DangerousPrototypes/BusPirateUltraHardware/BPUv1_case/freecad/images/bpu assembled - transparent front.png

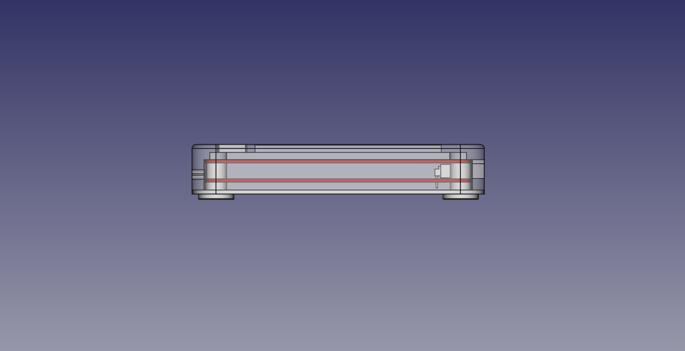
BPUv1_case/freecad/images/bpu assembled - transparent front.png
