DangerousPrototypes/BusPirateUltraHardware/BPUv1_case/freecad/images/bpu assembled - solid.png

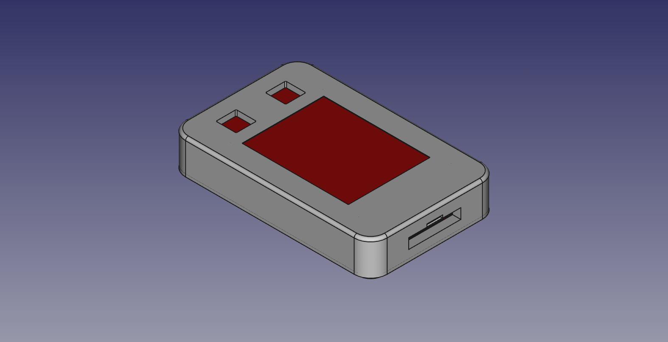
BPUv1_case/freecad/images/bpu assembled - solid.png
