DangerousPrototypes/BusPirateUltraHardware/README.md

# BusPirateUltraHardware
Schematic and PCBs for Bus Pirate Ultra
