DangerousPrototypes/BusPirateUltraHardware/BPU_display/font.bmp

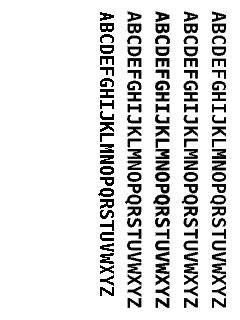
BPU_display/font.bmp
