DangerousPrototypes/BusPirateUltraHardware/BPUv1_case/freecad/images/bpu bottom.png

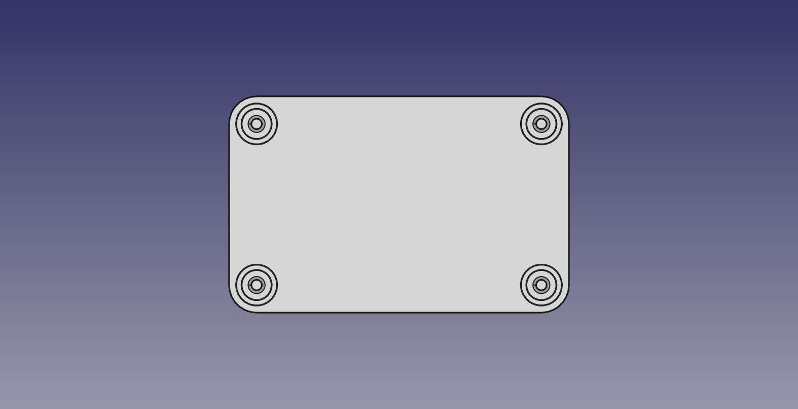
BPUv1_case/freecad/images/bpu bottom.png
