DangerousPrototypes/BusPirateUltraHardware/BPUv1_case/freecad/images/bpu top.png

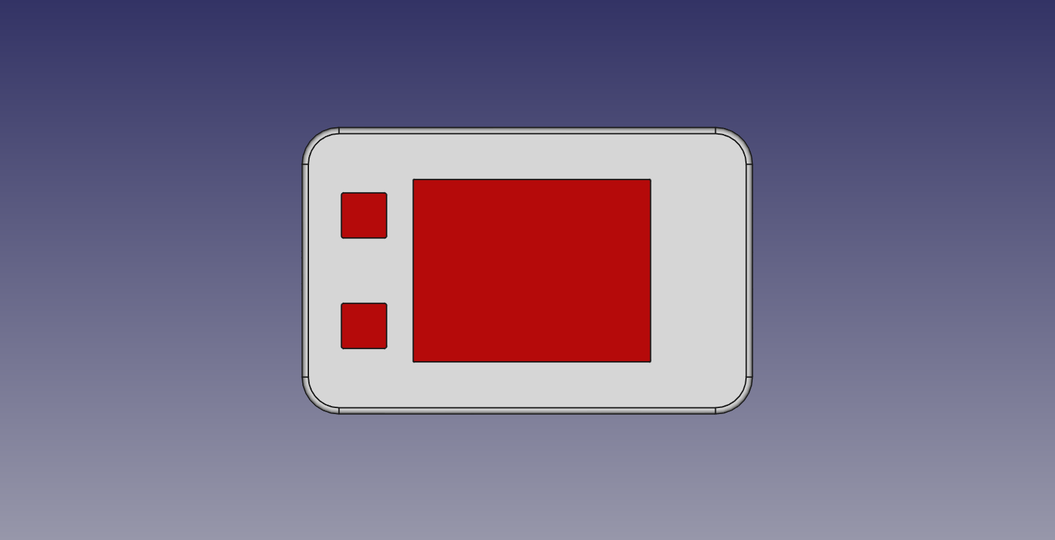
BPUv1_case/freecad/images/bpu top.png
