DangerousPrototypes/BusPirateUltraHardware/BPUv1_case/freecad/assemblies/All Bus Pirate Ultra v1.0 assembly.FCStd

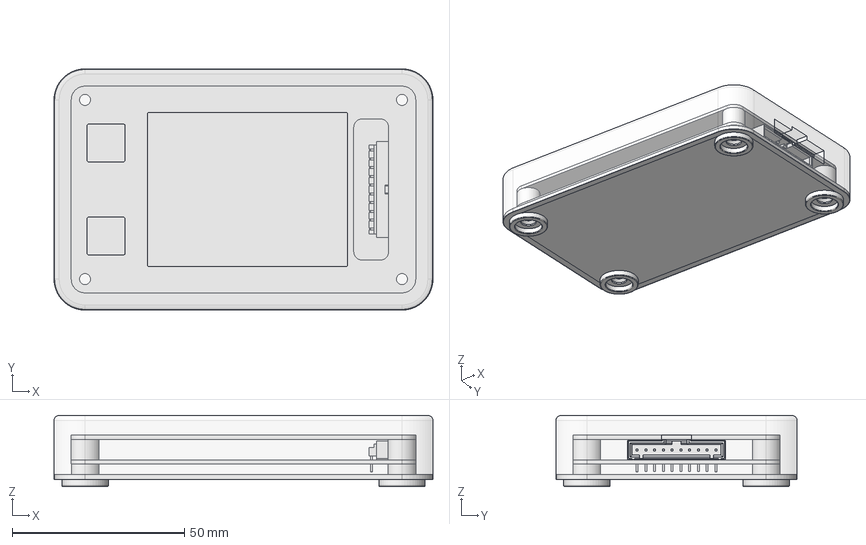
[picture p6: CAD file, 2020-06-01]
BPUv1_case/freecad/assemblies/All Bus Pirate Ultra v1.0 assembly.FCStd
110.0 x 70.0 x 20.7 mm
Bus Pirate Ultra v1.0 bottom plate_Body_001
spacer-3mm_001
spacer-3mm_002
spacer-3mm_003
spacer-3mm_004
spacer-6mm_001
spacer-6mm_002
spacer-6mm_003
spacer-6mm_004
Bus Pirate Ultra v1.0 display_001
PCB Bus Pirate Ultra v1.0 - assembly_001
Bus Pirate Ultra v1.0 case_Body001_001
