DangerousPrototypes/BusPirateUltraHardware/BPUv1_case/freecad/assemblies/PCB Bus Pirate Ultra v1.0 - assembly.FCStd

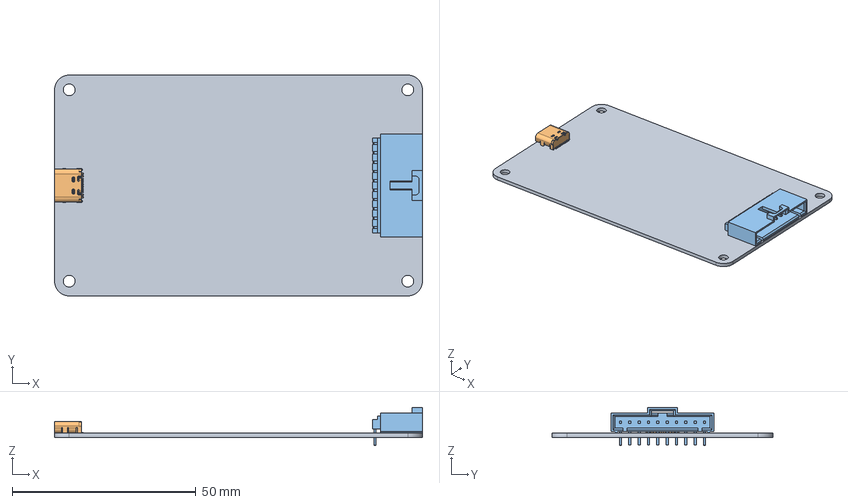
[picture p7: CAD file, 2020-06-01]
BPUv1_case/freecad/assemblies/PCB Bus Pirate Ultra v1.0 - assembly.FCStd
100.0 x 60.0 x 10.4 mm
PCB Bus Pirate Ultra v1.0_001
Part type-c-31-m-12-1_001
Part molex 7055 30044_001
