DangerousPrototypes/BusPirateUltraHardware/BPUv1_case/freecad/external sources/Part type-c-31-m-12-1.FCStd

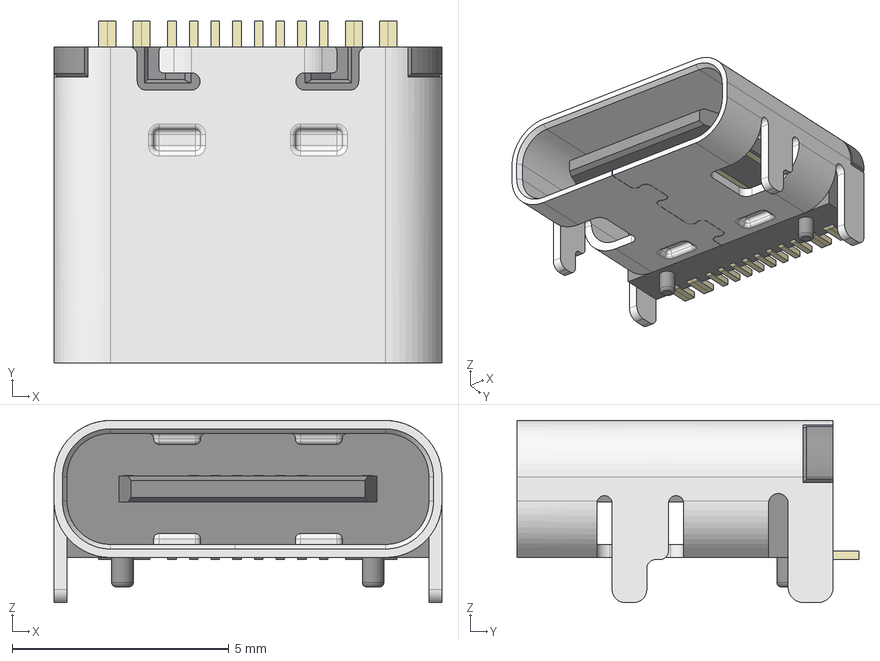
[picture p8: CAD file, 2020-06-01]
BPUv1_case/freecad/external sources/Part type-c-31-m-12-1.FCStd
8.95 x 7.90 x 4.20 mm
ConPins
PcbPins
Mold
Frame
