DangerousPrototypes/BusPirateUltraHardware/BPUv1_case/freecad/parts/Bus Pirate Ultra v1.2 case.FCStd

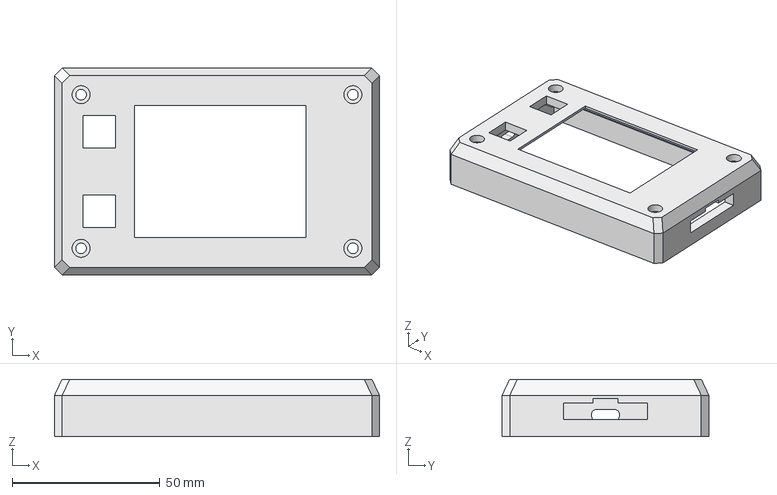
[picture p9: CAD file, 2021-04-14]
BPUv1_case/freecad/parts/Bus Pirate Ultra v1.2 case.FCStd
110.0 x 70.0 x 19.4 mm
