DangerousPrototypes/BusPirateUltraHardware/BPUv1_case/freecad/external sources/Part molex 7055 30044.FCStd

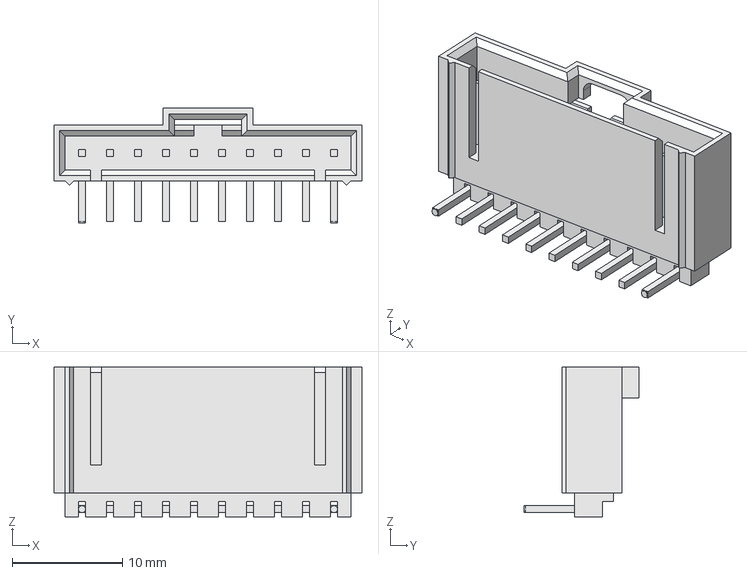
[picture p10: CAD file, 2020-06-01]
BPUv1_case/freecad/external sources/Part molex 7055 30044.FCStd
27.9 x 10.4 x 13.6 mm
