DangerousPrototypes/BusPirateUltraHardware/BPUv1_case/freecad/parts/Bus Pirate Ultra v1.1 bottom plate.FCStd

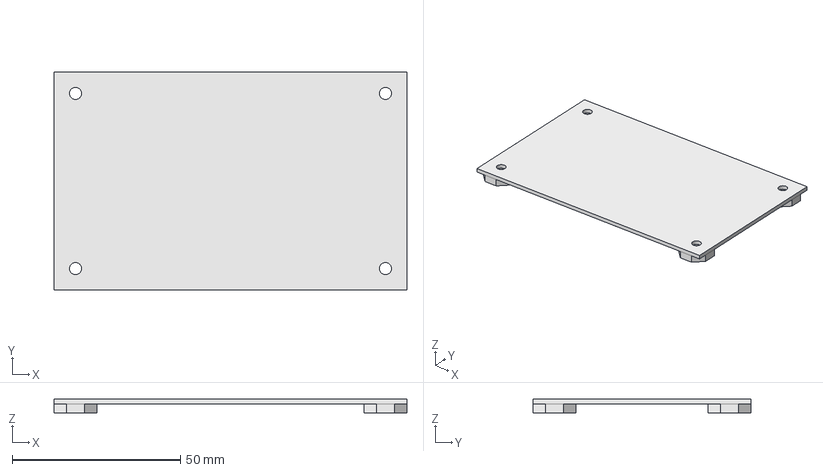
[picture p11: CAD file, 2021-04-13]
BPUv1_case/freecad/parts/Bus Pirate Ultra v1.1 bottom plate.FCStd
104.8 x 64.8 x 4.25 mm
