DangerousPrototypes/BusPirateUltraHardware/BPUv1_case/freecad/parts/spacer-6mm.FCStd

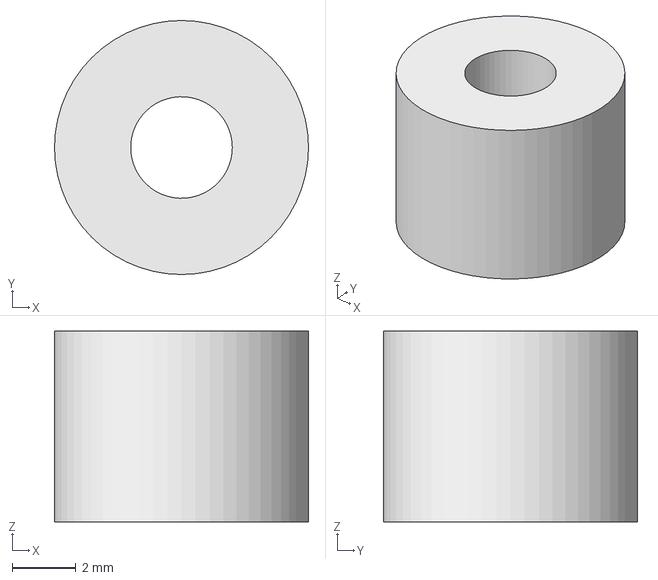
[picture p12: CAD file, 2020-06-01]
BPUv1_case/freecad/parts/spacer-6mm.FCStd
8.00 x 8.00 x 6.00 mm
