DangerousPrototypes/BusPirateUltraHardware/BPUv1_case/freecad/parts/spacer-3mm.FCStd

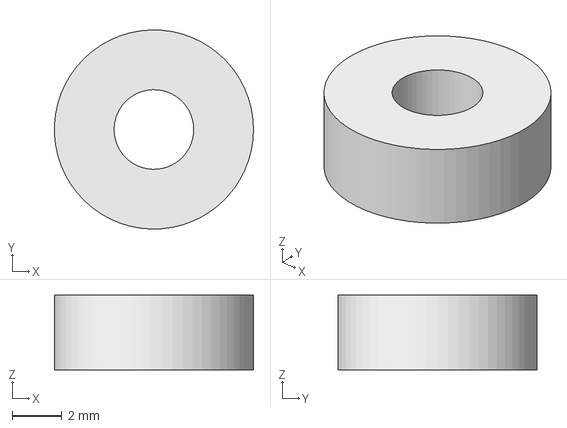
[picture p13: CAD file, 2020-06-01]
BPUv1_case/freecad/parts/spacer-3mm.FCStd
7.99 x 8.00 x 3.00 mm
