DangerousPrototypes/BusPirateUltraHardware/BPUv1_case/freecad/parts/PCB Bus Pirate Ultra v1.0.FCStd

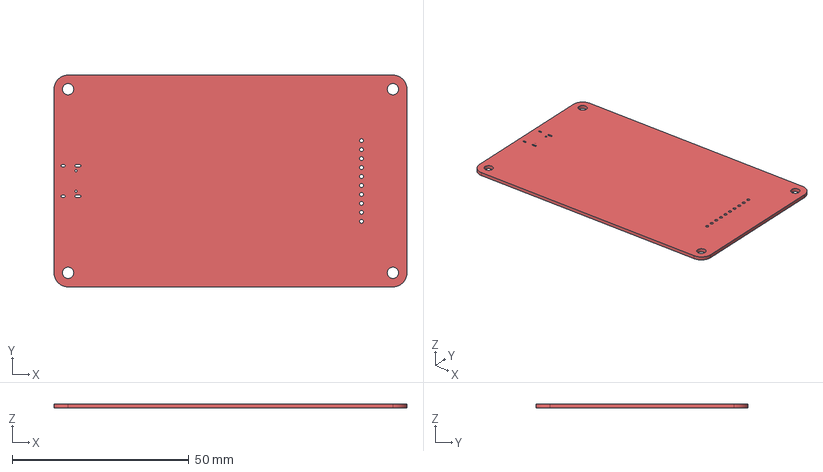
[picture p14: CAD file, 2020-06-01]
BPUv1_case/freecad/parts/PCB Bus Pirate Ultra v1.0.FCStd
100.0 x 60.0 x 1.20 mm
