DangerousPrototypes/BusPirateUltraHardware/BPUv1_case/freecad/parts/Bus Pirate Ultra v1.0 bottom plate.FCStd

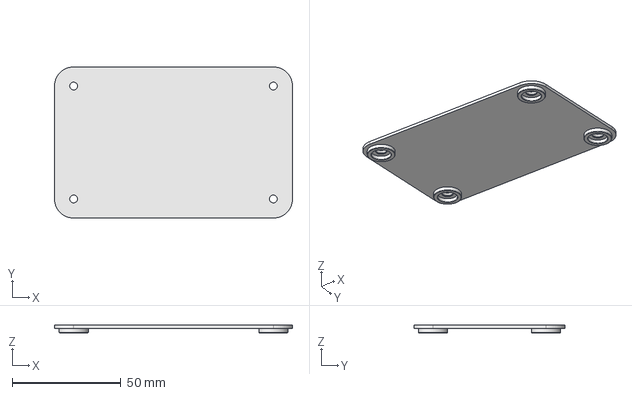
[picture p15: CAD file, 2020-06-01, an earlier design]
BPUv1_case/freecad/parts/Bus Pirate Ultra v1.0 bottom plate.FCStd
109.6 x 69.6 x 3.50 mm
