DangerousPrototypes/BusPirateUltraHardware/(list of files, cad)

Other CAD files:
BPU_display/board_outline.dwg
BPUv1_case/freecad/parts/PCB Bus Pirate Ultra v1.0 display.FCStd
BPUv1_case/freecad/parts/Bus Pirate Ultra v1.1 case.FCStd
BPUv1_case/freecad/parts/Bus Pirate Ultra v1.0 case.FCStd
