DangerousPrototypes/BusPirateUltraHardware/BPUv1_case/freecad/images/bpu assembled - ortho io side.png

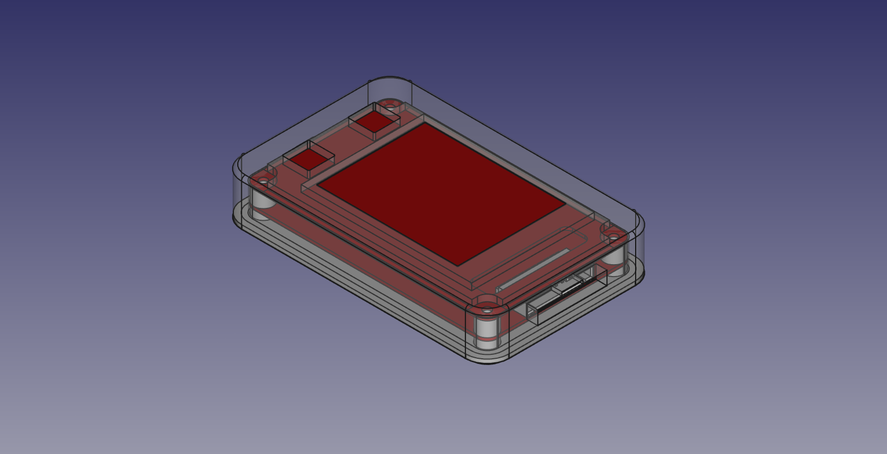
BPUv1_case/freecad/images/bpu assembled - ortho io side.png
