DangerousPrototypes/BusPirateUltraHardware/BPUv1_case/freecad/images/bpu assembled - transparent bottom ortho.png

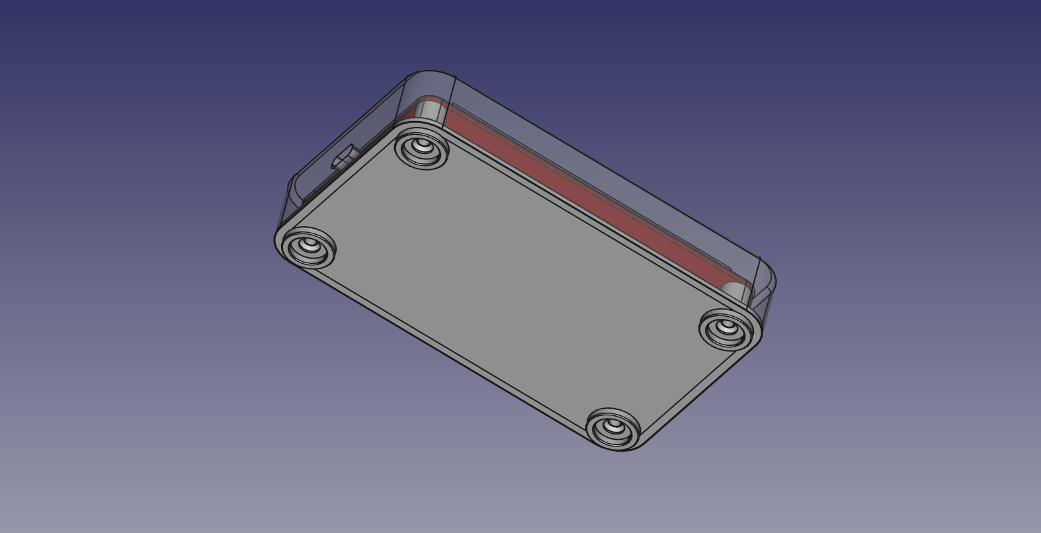
BPUv1_case/freecad/images/bpu assembled - transparent bottom ortho.png
