DangerousPrototypes/BusPirateUltraHardware/BPUv2a/BPUv2a.kicad_pcb

## KiCad design BPUv2a/BPUv2a.kicad_pcb (2020-04-21)

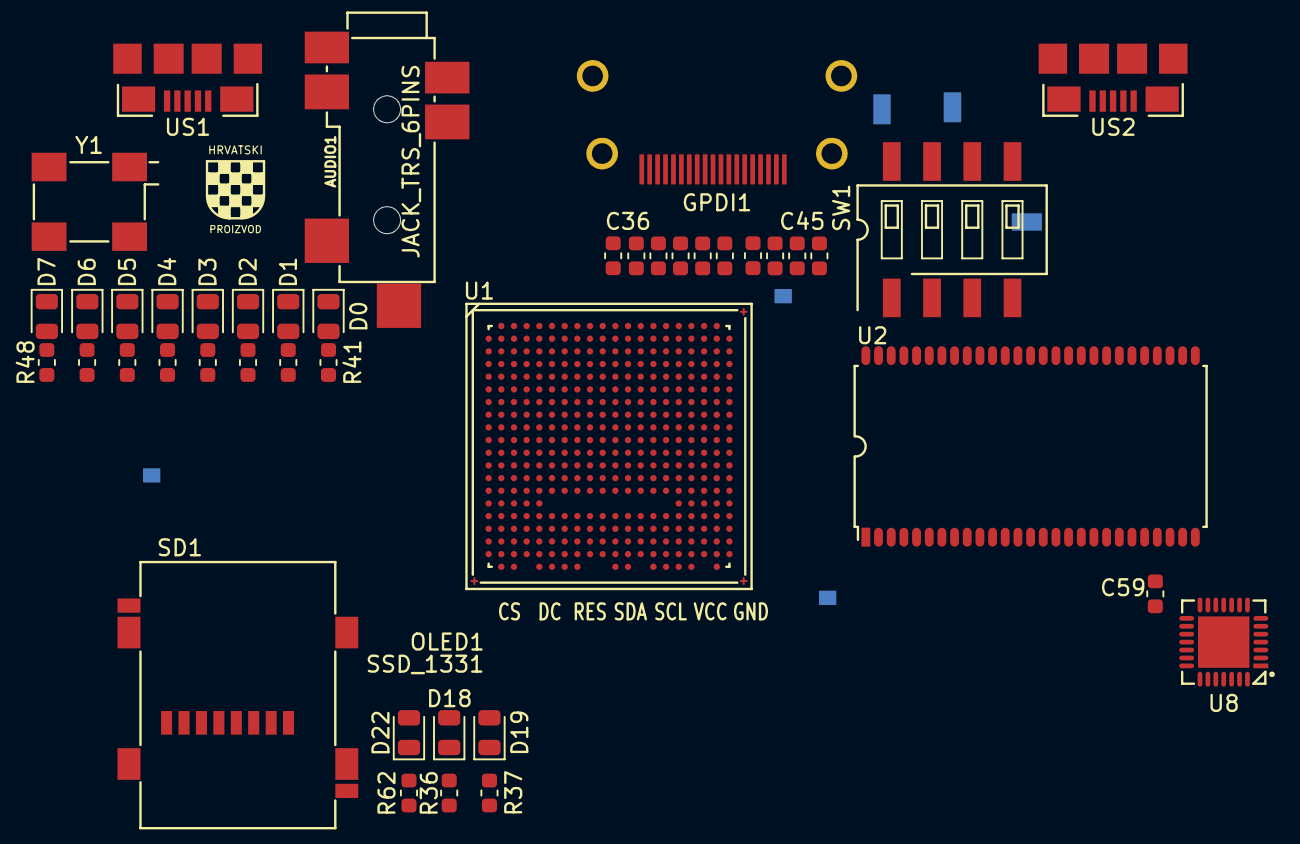
[picture p18: board BPUv2a.kicad_pcb from above]

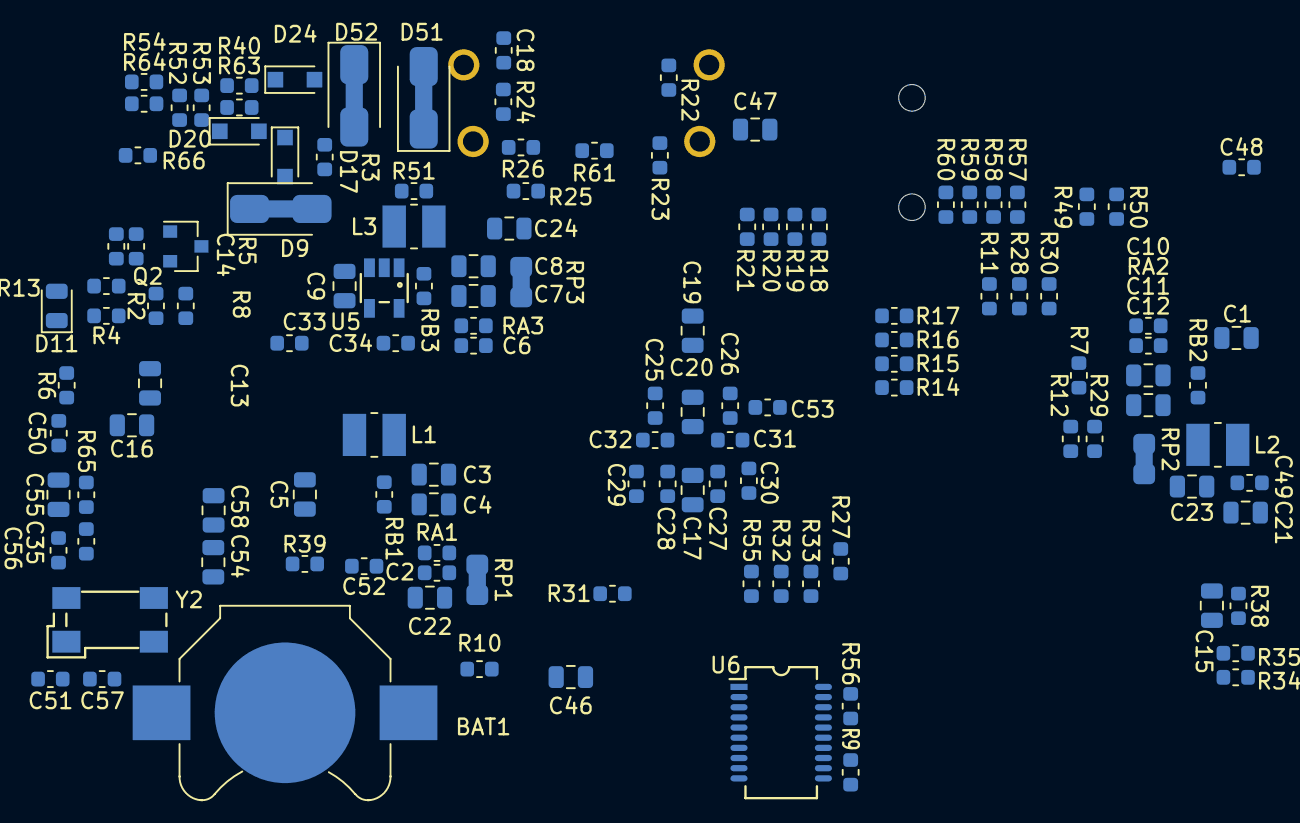
[picture p19: board BPUv2a.kicad_pcb from below]

Board: 4 copper layers, 171 parts (126 on the bottom side), 188 nets, no tracks yet.

Parts:
AUDIO1: JACK_TRS_6PINS; CUI_SJ-43516-SMT
BAT1: CR1225; Keystone_3000_1x12mm-CoinCell
C1, C3, C4, C5, C7, C8, C9, C11, C12, C15, C21, C54, C55, C58: 22uF; C_0805_2012Metric
C2, C6, C10, C18: 470pF; C_0603_1608Metric
C13, C16, C17, C19, C20, C22, C23, C24, C46, C47: 2.2uF; C_0805_2012Metric
C14, C36, C37, C38, C39, C40, C41, C42, C43, C44, C45, C59: 220nF; C_0603_1608Metric
C25, C26, C27, C28, C29, C30, C31, C32, C33, C34, C35, C48, C49, C50, C51, C52, C53: 22nF; C_0603_1608Metric
C56, C57: 3.3pF; C_0603_1608Metric
D0, D4, D11, D19: RED; LED_0805_2012Metric
D1, D5: ORANGE; LED_0805_2012Metric
D2, D6, D18: GREEN; LED_0805_2012Metric
D3, D7, D22: BLUE; LED_0805_2012Metric
D9, D51, D52: 0; D_SMA_Jumper_NC
D17, D24: 1N914; D_SOD-323_HandSoldering
D20: 3.6V; D_SOD-323_HandSoldering
GPDI1: GPDI-D; CONN-10029449-111RLF
HR: HR; hrvatski
L1, L2, L3: 2.2uH; L_1008_1210
OLED1: SSD_1331; oled_13xx
Q2: 2N7002; SOT-23
R2: 18k; R_0603_1608Metric
R3, R4, R25, R26, R30: 4.7k; R_0603_1608Metric
R5: 2.2M; R_0603_1608Metric
R6, R8, R14, R18, R29, R40, R54, R57, R66: 1.1k; R_0603_1608Metric
R7, R10, R17, R21, R39, R51, R60: 130; R_0603_1608Metric
R9, R13, R31, R32, R33, R34, R55, R63, R64: 15k; R_0603_1608Metric
R11, R12, R27, R28: 10k; R_0603_1608Metric
R15, R19, R35, R36, R37, R41, R42, R43, R44, R45, R46, R47, R48, R58, R61, R62, R65: 549; R_0603_1608Metric
R16, R20, R59: 270; R_0603_1608Metric
R22, R23: 3.3k; R_0603_1608Metric
R24: 100k; R_0603_1608Metric
R38: 0.47; R_0603_1608Metric
R49, R50, R52, R53: 27; R_0603_1608Metric
R56: 0; R_0603_1608Metric
RA1, RA2, RA3: 15k; R_0603_1608Metric
RB1: 18k; R_0603_1608Metric
RB2: 4.7k; R_0603_1608Metric
RB3: 3.3k; R_0603_1608Metric
RP1, RP2, RP3: 0; R_0805_2012Metric_Pad1.29x1.40mm_HandSolder_Jumper_NC
SD1: SCHD3A0100; SCHD3A100
SW1: SW_DIP_x04; SW_DIP_x4_W8.61mm_Slide_LowProfile
U1: LFE5U-85F-6BG381C; BGA-381_pitch0.8mm_dia0.4mm
U2: MT48LC16M16A2TG; TSOP54
U5: TLV62569DBV; TSOT-25
U6: FT231XS; FT231X-SSOP-20_4.4x6.5mm_Pitch0.65mm
U8: MAX11125; MAX1112x-TQFN-28-1EP_5x5mm_Pitch0.5mm
US1, US2: MICRO_USB; USB-MICRO-B-FCI-10118192-0001LF
Y1: FNETHE025; Crystal_SMD_7050_4Pads
Y2: 32768Hz; Crystal_SMD_ABS25

Connections:
2V5_3V3: C26.1, C47.1, C48.1, C49.1, C53.1, R51.1, U1.F9, U1.F10, U1.H6, U1.H7, U1.J6
+1V1: C17.1, C27.1, C28.1, RP1.2, U1.H8, U1.H9, U1.H10, U1.H11, U1.H12, U1.H13, U1.J8, U1.J13, U1.K8, U1.K13, U1.L8, U1.L13, U1.M8, U1.M13, U1.N8, U1.N9, U1.N10, U1.N11, U1.N12, U1.N13
+2V5: C19.1, C29.1, C30.1, R22.1, R23.1, RP2.2, U1.F6, U1.F15, U1.P6, U1.P15
+3V3: C16.1, C20.1, C21.1, C25.1, C31.1, C32.1, C33.1, C34.1, C35.1, C46.1, C50.1, C51.1, C52.1, D11.2, R7.1, R11.1, R12.1, R27.1, R28.1, R29.1, R30.1, R31.1, R32.1, R33.1, R34.1, R38.2, R39.1, R65.1, RP3.2, U1.F11, U1.F12, U1.H14, U1.H15, U1.J15, U1.L6, U1.L7, U1.L14, U1.L15, U1.M6, U1.M15, U1.P9, U1.P10, U1.T2, U1.T3, U1.T4, U1.U2, U2.1, U2.3, U2.9, U2.14, U2.27, U2.43, U2.49, Y1.1, Y1.4
+5V: C1.1, C5.1, C9.1, C13.1, D9.2, D51.1, D52.2, GPDI1.18, R3.1, R24.1, R25.1, R26.1, U5.4
/analog/ADC3V3: C58.1, C59.1, U8.15, U8.17, U8.18
/analog/AUDIO_L: AUDIO1.2, R14.2, R15.2, R16.2, R17.2
/analog/AUDIO_R: AUDIO1.3, R18.2, R19.2, R20.2, R21.2
/analog/AUDIO_V: AUDIO1.4, R57.2, R58.2, R59.2, R60.2
/blinkey/ALED0: D0.2, R41.2
/blinkey/ALED1: D1.2, R42.2
/blinkey/ALED2: D2.2, R43.2
/blinkey/ALED3: D3.2, R44.2
/blinkey/ALED4: D4.2, R45.2
/blinkey/ALED5: D5.2, R46.2
/blinkey/ALED6: D6.2, R47.2
/blinkey/ALED7: D7.2, R48.2
/blinkey/LED_PWREN: D18.1, R36.1
/blinkey/LED_TXLED: D19.1, R37.2
/blinkey/LED_WIFI: D22.1, R62.1
/blinkey/SWPU: R51.2, SW1.1, SW1.2, SW1.3, SW1.4
/flash/FLASH_MISO: R28.2, U1.V2
/flash/FLASH_MOSI: R27.2, U1.W2
/flash/FLASH_SCK: R29.2, U1.U3
/flash/FLASH_nCS: R30.2, U1.R2
/flash/FLASH_nHOLD: R12.2, U1.W1
/flash/FLASH_nWP: R11.2, U1.Y2
/flash/FPGA_DONE: R32.2, R55.1, U1.Y3
/flash/FPGA_INITN: R33.2, U1.V3
/flash/FPGA_PROGRAMN: R31.2, U1.W3
/gpdi/FPDI_CEC: R61.2, U1.A18
/gpdi/GPDI_CLK+: C45.2, GPDI1.10
/gpdi/GPDI_CLK-: C41.2, GPDI1.12
/gpdi/GPDI_D0+: C44.2, GPDI1.7
/gpdi/GPDI_D0-: C40.2, GPDI1.9
/gpdi/GPDI_D1+: C43.2, GPDI1.4
/gpdi/GPDI_D1-: C39.2, GPDI1.6
/gpdi/GPDI_D2+: C42.2, GPDI1.1
/gpdi/GPDI_D2-: C38.2, GPDI1.3
/gpdi/GPDI_ETH+: C36.2, GPDI1.14
/gpdi/GPDI_ETH-: C37.2, GPDI1.19
/gpdi/VREF2: C18.1, R24.2
/power/FB1: C2.2, RA1.2, RB1.2
/power/FB2: C10.2, RA2.2, RB2.2
/power/FB3: C6.2, RA3.2, RB3.2, U5.5
/power/HOLD: D11.1, R4.1
/power/L3: L3.1, U5.3
/power/OSCI_32k: C56.2, Y2.4
/power/OSCO_32k: C57.2, Y2.1
/power/P1V1: C2.1, C3.1, C4.1, C22.1, L1.2, RA1.1, RP1.1
/power/P2V5: C10.1, C11.1, C12.1, C23.1, L2.2, RA2.1, RP2.1
/power/P3V3: C6.1, C7.1, C8.1, C24.1, L3.2, RA3.1, RP3.1
/power/PWREN: R2.1, R4.2, R8.1, U5.1
/power/RTCVDD: C55.1, R65.2
/power/SHD: Q2.3, R8.2
/power/SHUT: C14.1, Q2.1, R5.1
/power/VBAT: BAT1.1, C54.1
/sdcard/SD3V3: C15.1, R38.1, SD1.4
/usb/FPD+: R53.2, US2.3
/usb/FPD-: R52.2, US2.2
/usb/FTD+: R50.2, US1.3
/usb/FTD-: R49.2, US1.2
/usb/US2VBUS: D9.1, US2.1
ADC_CSn: U1.R17, U8.20
ADC_MISO: U1.U16, U8.24
ADC_MOSI: U1.R16, U8.21
ADC_SCLK: U1.P17, U8.19
AUDIO_L0: R14.1, U1.E4
AUDIO_L1: R15.1, U1.D3
AUDIO_L2: R16.1, U1.C3
AUDIO_L3: R17.1, U1.B3
AUDIO_R0: R18.1, U1.A3
AUDIO_R1: R19.1, U1.B5
AUDIO_R2: R20.1, U1.D5
AUDIO_R3: R21.1, U1.C5
AUDIO_V0: R57.1, U1.H5
AUDIO_V1: R58.1, U1.F2
AUDIO_V2: R59.1, U1.F5
AUDIO_V3: R60.1, U1.E5
BTN_PWRn: D17.2, U1.D6
CLK_25MHz: U1.G2, Y1.3
FPDI_CLK+: C45.1, U1.A17
FPDI_CLK-: C41.1, U1.B18
FPDI_D0+: C44.1, U1.A16
FPDI_D0-: C40.1, U1.B16
FPDI_D1+: C43.1, U1.A14
FPDI_D1-: C39.1, U1.C14
FPDI_D2+: C42.1, U1.A12
FPDI_D2-: C38.1, U1.A13
FPDI_ETH+: C36.1, U1.A19
FPDI_ETH-: C37.1, U1.B20
FPDI_SCL: R23.2, U1.E12
FPDI_SDA: R22.2, U1.B19
FT2V5: D19.2, R9.2, U6.3, U6.13
FTDI_RXD: U1.L4, U6.4
FTDI_TXD: U1.M1, U6.20
FTDI_TXDEN: R56.2, U1.L3, U6.18
FTDI_nDTR: U1.N1, U6.1
FTDI_nRTS: U1.M3, U6.2
FTDI_nRXLED: U1.L5, U6.17
FTDI_nSLEEP: D18.2, R10.2, U6.19
FTDI_nTXLED: R37.1, U6.10
GN14: U1.U17, U8.26
GN15: U1.P16, U8.28
GN16: U1.M17, U8.2
GN17: U1.L17, U8.4
GND: AUDIO1.1, BAT1.2, C1.2, C3.2, C4.2, C5.2, C7.2, C8.2, C9.2, C11.2, C12.2, C14.2, C15.2, C16.2, C17.2, C18.2, C19.2, C20.2, C21.2, C22.2, C23.2, C24.2, C25.2, C26.2, C27.2, C28.2, C29.2, C30.2, C31.2, C32.2, C33.2, C34.2, C35.2, C46.2, C47.2, C48.2, C49.2, C50.2, C51.2, C52.2, C53.2, C54.2, C55.2, C56.1, C57.1, C58.2, C59.2, D0.1, D1.1, D2.1, D3.1, D4.1, D5.1, D6.1, D7.1, D20.2, GPDI1.0, GPDI1.2, GPDI1.5, GPDI1.8, GPDI1.11, GPDI1.17, Q2.2, R2.2, R5.2, R13.2, R36.2, R56.1, R62.2, RB1.1, RB2.1, RB3.1, SD1.6, SD1.9, SD1.10, SD1.11, U1.B7, U1.B14, U1.C19, U1.D4, U1.F7, U1.F8, U1.F13, U1.F14, U1.G4, U1.G6, U1.G7, U1.G8, U1.G9, U1.G10, U1.G11, U1.G12, U1.G13, U1.G14, U1.G15, U1.G17, U1.H19, U1.J2, U1.J7, U1.J9, U1.J10, U1.J11, U1.J12, U1.J14, U1.K6, U1.K7, U1.K9, U1.K10, U1.K11, U1.K12, U1.K14, U1.K15, U1.L9, U1.L10, U1.L11, U1.L12, U1.M2, U1.M7, U1.M9, U1.M10, U1.M11, U1.M12, U1.M14, U1.M16, U1.N6, U1.N7, U1.N14, U1.N15, U1.P7, U1.P8, U1.P11, U1.P12, U1.P13, U1.P14, U1.R4, U1.R19, U1.T6, U1.T7, U1.T8, U1.T9, U1.T10, U1.T11, U1.T12, U1.T13, U1.T14, U1.T15, U1.U4, U1.U6, U1.U7, U1.U8, U1.U9, U1.U10, U1.U11, U1.U12, U1.U13, U1.U14, U1.U15, U1.V5, U1.V6, U1.V7, U1.V8, U1.V9, U1.V10, U1.V11, U1.V12, U1.V13, U1.V14, U1.V15, U1.V16, U1.V17, U1.V18, U1.V19, U1.V20, U1.W6, U1.W7, U1.W12, U1.W15, U1.W16, U1.W19, U1.W20, U1.Y5, U1.Y6, U1.Y7, U1.Y8, U1.Y11, U1.Y12, U1.Y14, U1.Y15, U1.Y16, U1.Y17, U1.Y19, U2.6, U2.12, U2.28, U2.41, U2.46, U2.52, U2.54, U5.2, U6.6, U6.16, U8.6, U8.7, U8.8, U8.9, U8.10, U8.11, U8.13, U8.14, U8.16, U8.22, U8.29, US1.5, US1.6, US2.5, US2.6, Y1.2
GP14: U1.U18, U8.27
GP15: U1.N17, U8.1
GP16: U1.N16, U8.3
GP17: U1.L16, U8.5
GPDI_CEC: GPDI1.13, R61.1
GPDI_SCL: GPDI1.15, R25.2
GPDI_SDA: GPDI1.16, R26.2
JTAG_TCK: U1.T5, U6.7
JTAG_TDI: U1.R5, U6.5
JTAG_TDO: U1.V4, U6.9
JTAG_TMS: U1.U5, U6.8
LED0: R41.1, U1.B2
LED1: R42.1, U1.C2
LED2: R43.1, U1.C1
LED3: R44.1, U1.D2
LED4: R45.1, U1.D1
LED5: R46.1, U1.E2
LED6: R47.1, U1.E1
LED7: R48.1, U1.H3
unnamed: D24.1, R40.1
PWRBTn: D17.1, R3.2
SDRAM_A0: U1.M20, U2.23
SDRAM_A1: U1.M19, U2.24
SDRAM_A2: U1.L20, U2.25
SDRAM_A3: U1.L19, U2.26
SDRAM_A4: U1.K20, U2.29
SDRAM_A5: U1.K19, U2.30
SDRAM_A6: U1.K18, U2.31
SDRAM_A7: U1.J20, U2.32
SDRAM_A8: U1.J19, U2.33
SDRAM_A9: U1.H20, U2.34
SDRAM_A10: U1.N19, U2.22
SDRAM_A11: U1.G20, U2.35
SDRAM_A12: U1.G19, U2.36
SDRAM_BA0: U1.P19, U2.20
SDRAM_BA1: U1.N20, U2.21
SDRAM_CKE: U1.F20, U2.37
SDRAM_CLK: U1.F19, U2.38
SDRAM_D0: U1.J16, U2.2
SDRAM_D1: U1.L18, U2.4
SDRAM_D2: U1.M18, U2.5
SDRAM_D3: U1.N18, U2.7
SDRAM_D4: U1.P18, U2.8
SDRAM_D5: U1.T18, U2.10
SDRAM_D6: U1.T17, U2.11
SDRAM_D7: U1.U20, U2.13
SDRAM_D8: U1.E19, U2.42
SDRAM_D9: U1.D20, U2.44
SDRAM_D10: U1.D19, U2.45
SDRAM_D11: U1.C20, U2.47
SDRAM_D12: U1.E18, U2.48
SDRAM_D13: U1.F18, U2.50
SDRAM_D14: U1.J18, U2.51
SDRAM_D15: U1.J17, U2.53
SDRAM_DQM0: U1.U19, U2.15
SDRAM_DQM1: U1.E20, U2.39
SDRAM_nCAS: U1.T19, U2.17
SDRAM_nCS: U1.P20, U2.19
SDRAM_nRAS: U1.R20, U2.18
SDRAM_nWE: U1.T20, U2.16
SD_CLK: SD1.5, U1.H2
SD_CMD: SD1.3, U1.J1
SD_D0: SD1.7, U1.J3
SD_D1: SD1.8, U1.H1
SD_D2: SD1.1, U1.K1
SD_D3: SD1.2, U1.K2
SHUTDOWN: R13.1, U1.G16
SW1: SW1.8, U1.E8
SW2: SW1.7, U1.D8
SW3: SW1.6, U1.D7
SW4: SW1.5, U1.E7
US2_ID: R66.1, US2.4
USB5V: U6.15, US1.1
USB_FPGA_D+: D20.1, R40.2, R53.1, R63.2, U1.D15, U1.E16
USB_FPGA_D-: R52.1, R54.1, R64.2, U1.E15, U1.F16
USB_FPGA_PULL_D+: D24.2, U1.B12
USB_FTDI_D+: R50.1, U6.11
USB_FTDI_D-: R49.1, U6.12
WIFI_EN: R34.2, R35.1, U1.F1
WIFI_GPIO5: D22.2, U1.N4
nRESET: R9.1, U6.14
