DangerousPrototypes/BusPirateUltraHardware/BPU_display/BPU_display-v1d-28inch.brd

## EAGLE design BPU_display/BPU_display-v1d-28inch.brd (2019-12-14)

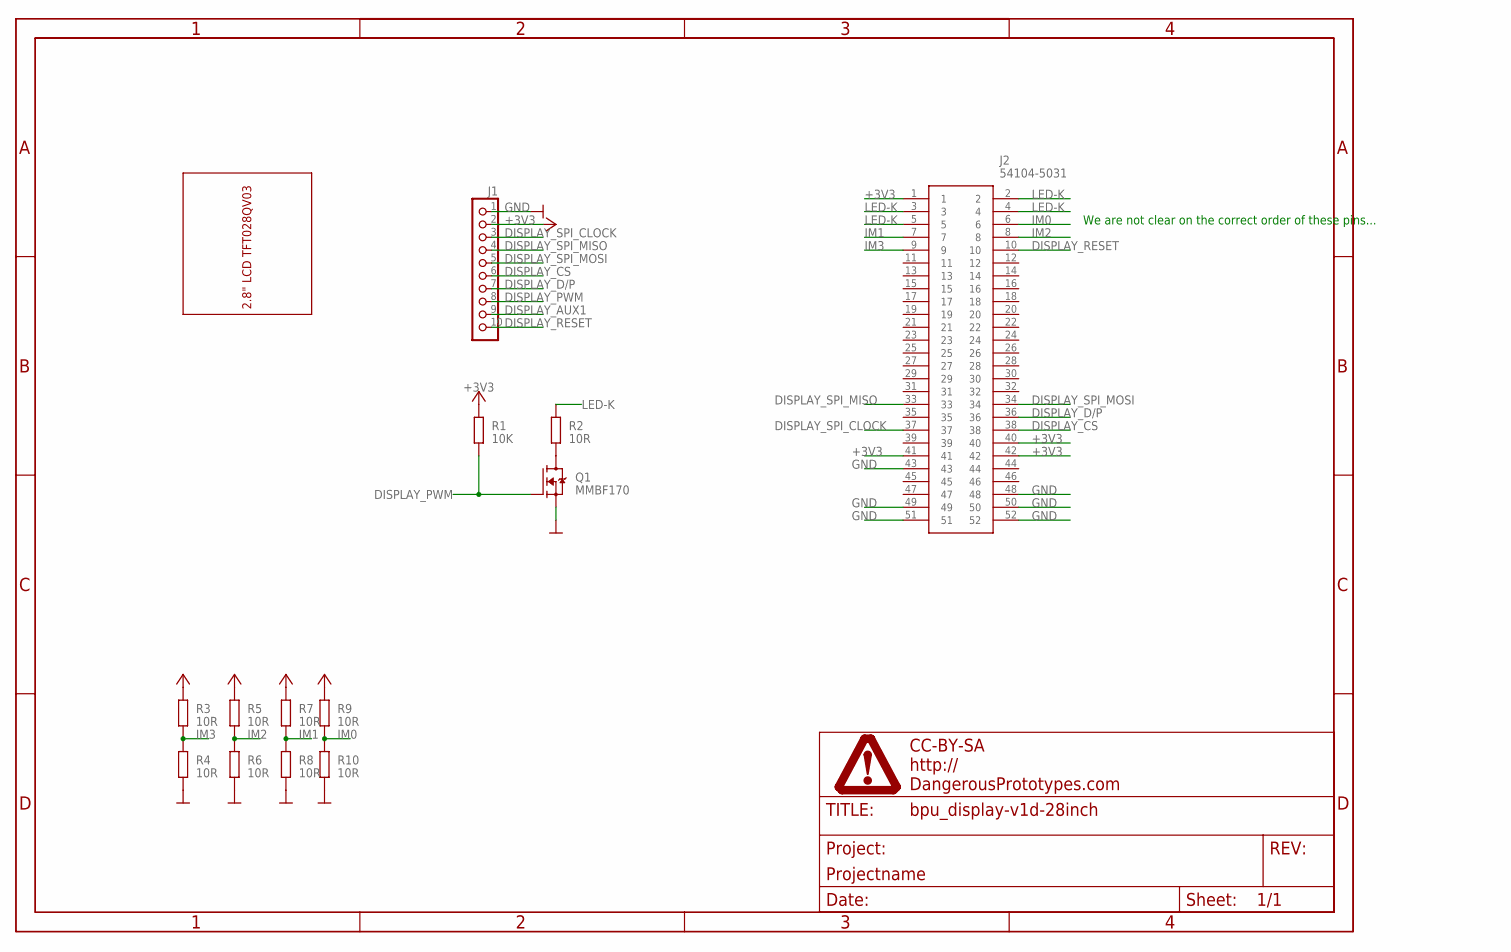
[picture p20: schematic BPU_display-v1d-28inch.sch]

Parts:
J1: CON-FPC_X05B20L10T; X05B20L10T
J2: 54104-5031; 541045031
PAGE1: FRAME_DINA4_L; DP_LOGO
Q1: MMBF170; SOT-23
R1: 10K; R0603
R2, R3, R4, R5, R6, R7, R8, R9, R10: 10R; R0603
U$1: LCDS; 2.8INCHLCD

Connections:
+3V3: J1.2, J2.1, J2.40, J2.41, J2.42, R1.2, R3.2, R5.2, R7.2, R9.2
DISPLAY_AUX1: J1.9
DISPLAY_CS: J1.6, J2.38
DISPLAY_D/P: J1.7, J2.36
DISPLAY_PWM: J1.8, Q1.1 (G), R1.1
DISPLAY_RESET: J1.10, J2.10
DISPLAY_SPI_CLOCK: J1.3, J2.37
DISPLAY_SPI_MISO: J1.4, J2.33
DISPLAY_SPI_MOSI: J1.5, J2.34
GND: J1.1, J2.43, J2.48, J2.49, J2.50, J2.51, J2.52, Q1.2 (S), R4.1, R6.1, R8.1, R10.1
IM0: J2.6, R9.1, R10.2
IM1: J2.7, R7.1, R8.2
IM2: J2.8, R5.1, R6.2
IM3: J2.9, R3.1, R4.2
LED-K: J2.2, J2.3, J2.4, J2.5, R2.2
unnamed: Q1.3 (D), R2.1

Notes on the sheet:
We are not clear on the correct order of these pins...

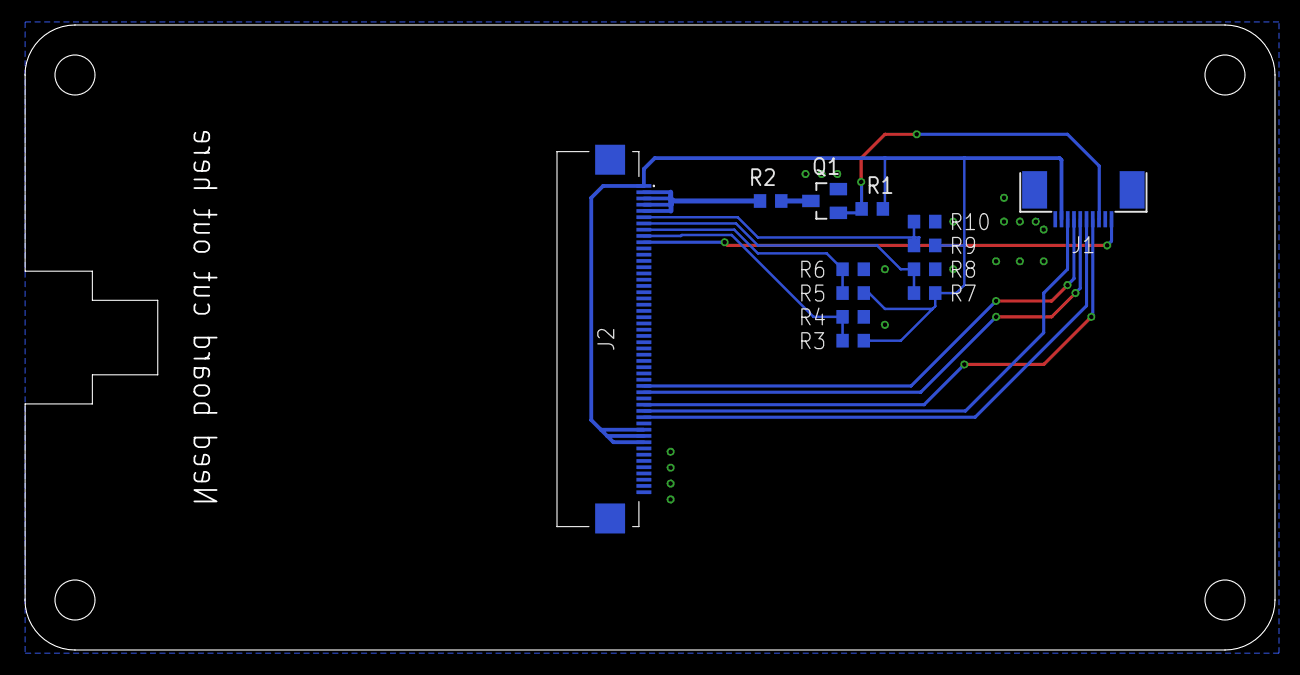
[picture p21: board BPU_display-v1d-28inch.brd from below]

Board: 2 copper layers, 100.0 x 50.0 mm, 15 parts (13 on the bottom side), 15 nets.
