DangerousPrototypes/BusPirateUltraHardware/BPUv1b/BusPirate-LCD.v0a.brd

## EAGLE design BPUv1b/BusPirate-LCD.v0a.brd (2019-12-14)

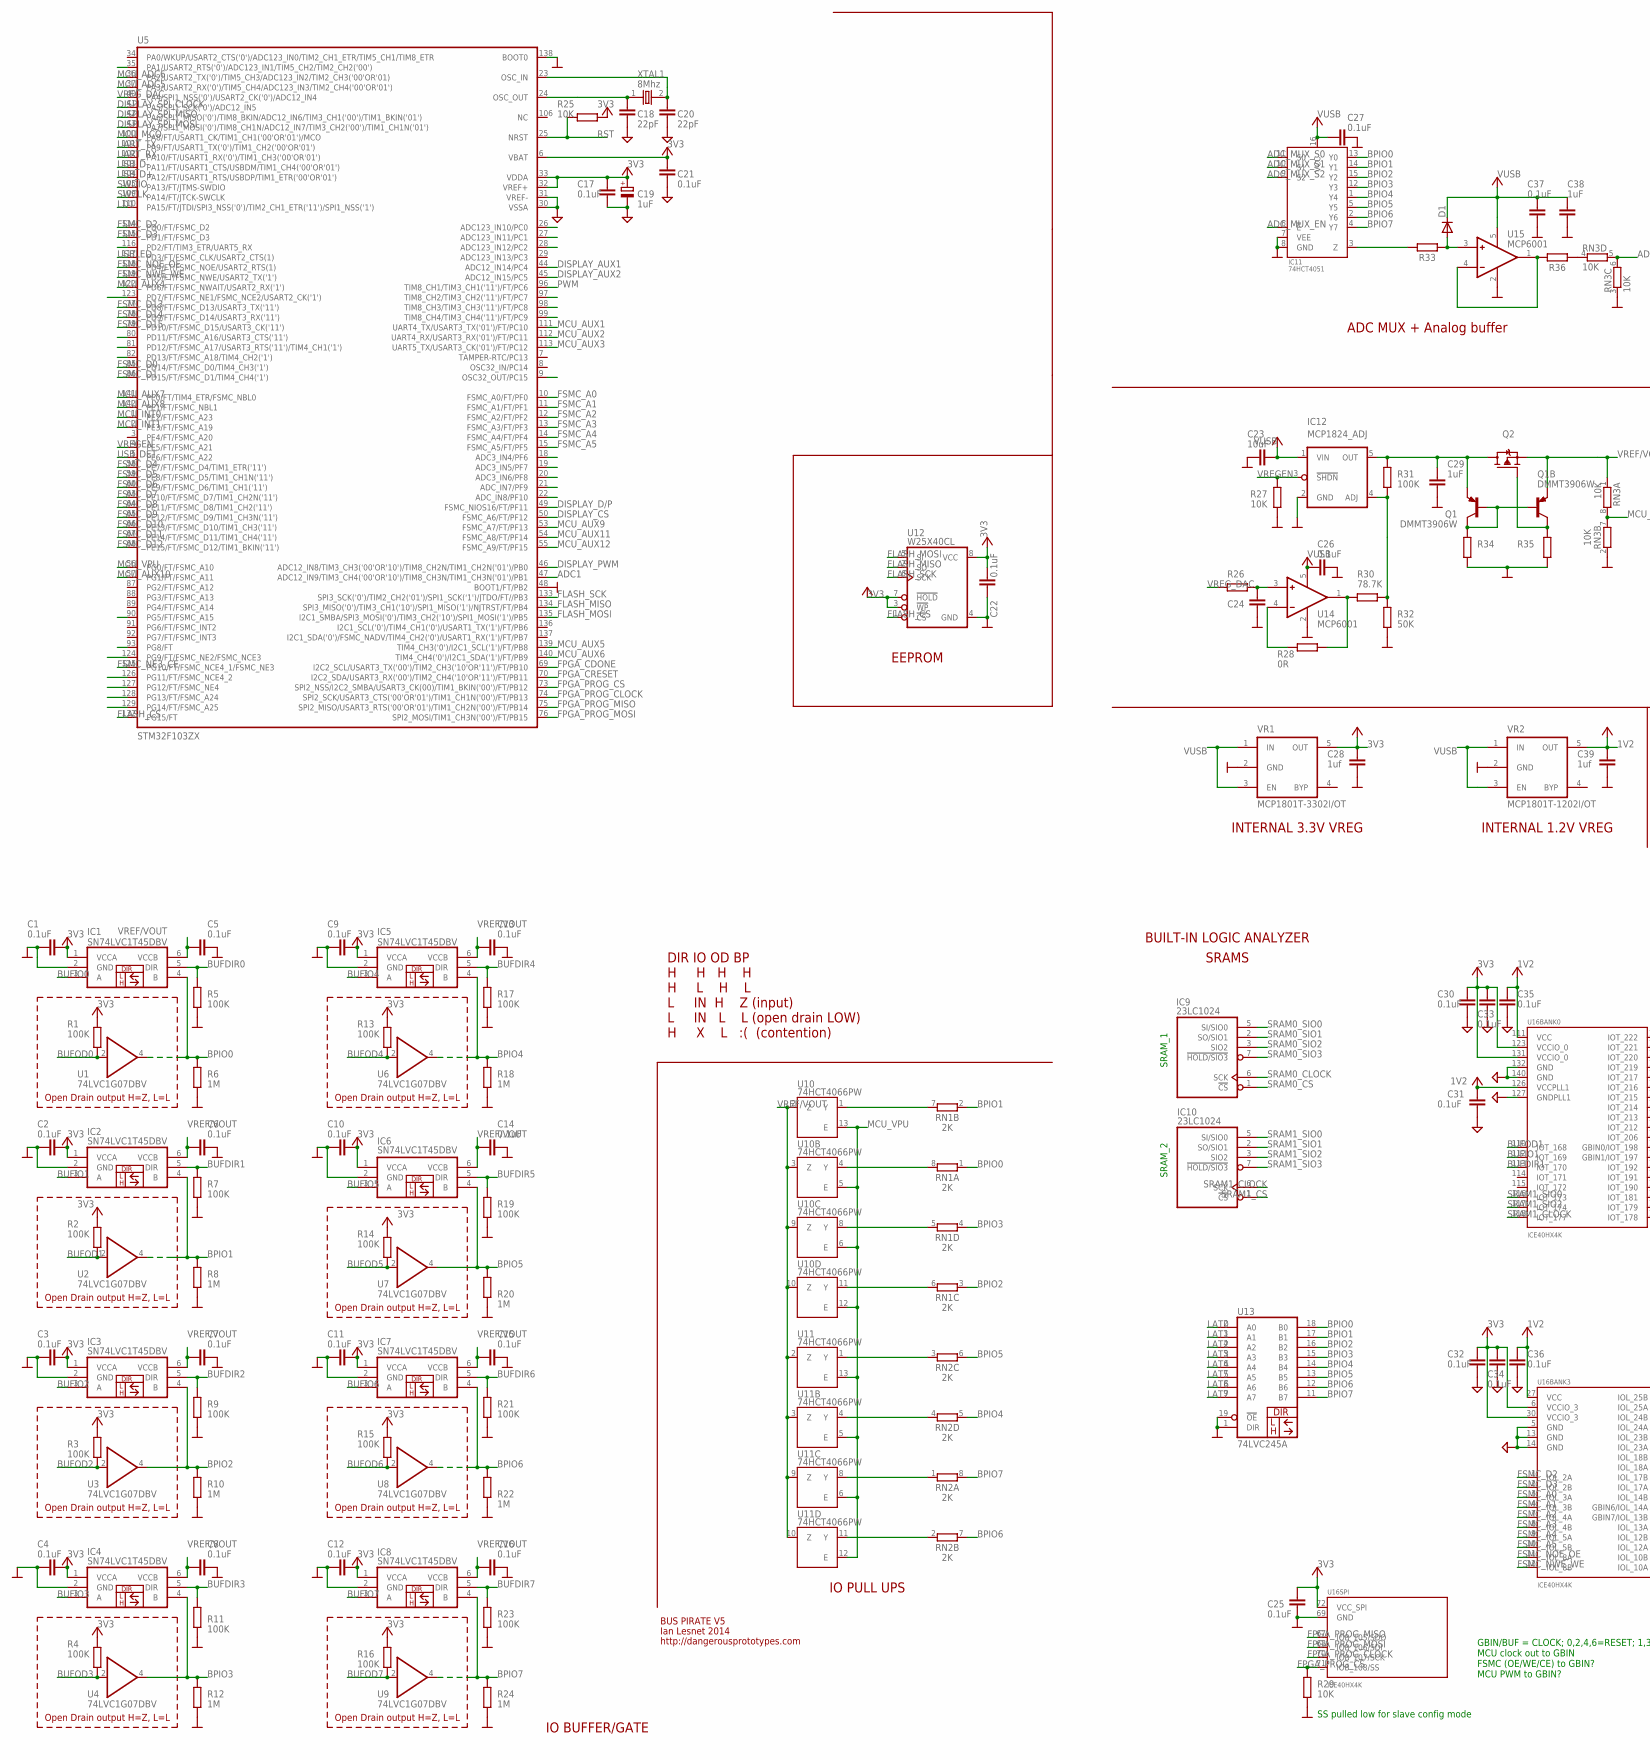
[picture p22: schematic BusPirate-LCD.v0a.sch, part in row 1, column 1]

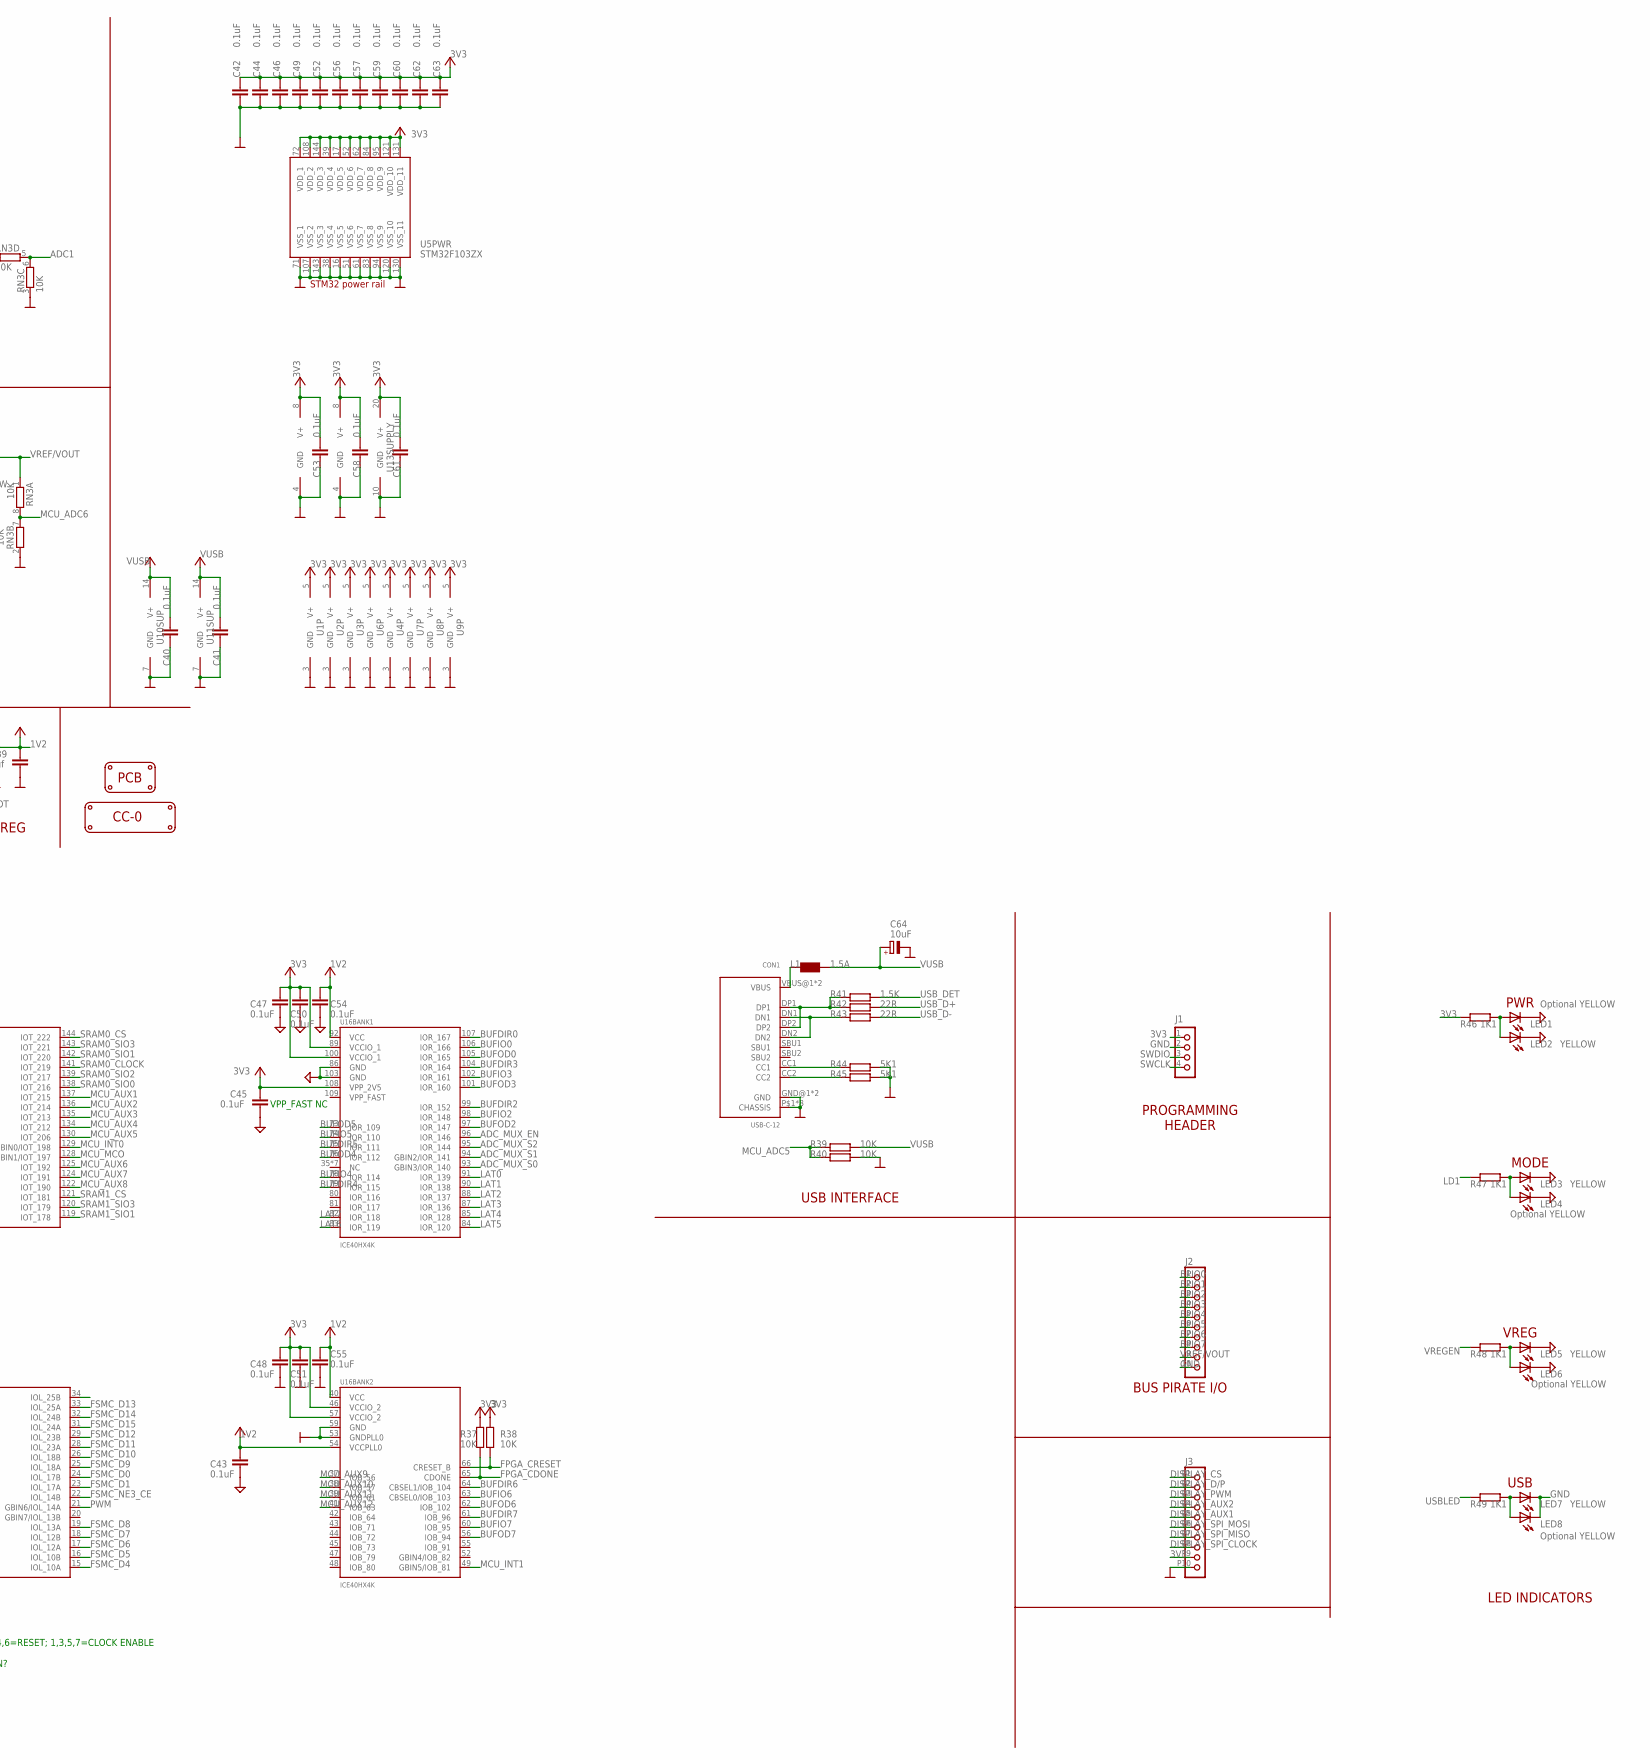
[picture p23: schematic BusPirate-LCD.v0a.sch, part in row 1, column 2]

Parts:
C1, C2, C3, C4, C5, C6, C7, C8, C9, C10, C11, C12, C13, C14, C15, C16: 0.1uF; C0402
C17, C21, C22, C25, C26, C27, C30, C31, C33, C34, C35, C37, C40, C41, C42, C43, C44, C45, C46, C47, C48, C49, C50, C51, C52, C53, C54, C55, C56, C57, C58, C60, C61, C62, C63: 0.1uF; C0603
C18, C20: 22pF; C0603
C19: 1uF; SMC_A
C23: 10uF; C603
C24: C-EUC0603; C0603
C28, C39: 1uf; C0603
C29: 1uF; C603
C32, C36, C59: 0.1uF; C402
C38: 1uF; C0603
C64: 10uF; SMC_A
CON1: USB-C-12; C-31-M-12
D1: DIODE-SOD-123; SOD-123
IC1, IC2, IC3, IC4, IC5, IC6, IC7, IC8: SN74LVC1T45DBV; SC-70-6_EXTENDED_PADS
IC9, IC10: 23LC1024; SOIC-8
IC11: 74HCT4051; TSSOP-16
IC12: MCP1824_ADJ; SOT-23-5
J1: CON_HEADER_1X04; M1X4
J2: CON_HEADER_1X10-RIGHT_ANGLED_PTH_SHROUDED; M1X10_MALE_RIGHT_ANGLES_PTH_SHROUDED
J3: CON_MOLEX_MALE_SMT_SH_1.25; MOLEX_533980771
L1: 1.5A; WE-KI_0805_B
LED1, LED4, LED6, LED8: Optional YELLOW; LED-805
LED2, LED3, LED5, LED7: YELLOW; LED-805
LOGO1: LOGO_CC-0
PCB1: PCB_DP_RECTANGLE-50X100; DP10050_V1
Q1: DMMT3906W; SOT-363
Q2: TRANSISTOR_FET_TSM2301CX; SOT-23
R1, R2, R3, R4, R5, R7, R9, R11, R13, R14, R15, R16, R17, R19, R21, R23: 100K; R0402
R6, R8, R10, R12, R18, R20, R22, R24: 1M; R0402
R25, R27: 10K; R603
R26, R33, R36: R-EU_R0603; R0603
R28: 0R; R603
R29, R37, R38, R39, R40: 10K; R0603
R30: 78.7K; R603
R31: 100K; R603
R32: 50K; R603
R34, R35: RESISTOR-0603; R603
R41: 1.5K; R0603
R42, R43: 22R; R0603
R44, R45: 5K1; R0603
R46, R47, R48, R49: 1K1; R603
RN1, RN2: 2K; RN8P-4R-CRA06S
RN3: 10K; RN8P-4R-CRA06S
U1, U2, U3, U4, U6, U7, U8, U9: 74LVC1G07DBV; SC-70-5_EXTENDED_PADS
U5: STM32F103ZX; TQFP-144
U10, U11: 74HCT4066PW; TSSOP-14
U12: W25X40CL; SOIC-8
U13: 74LVC245A; TSSOP-20
U14, U15: MCP6001; SOT-23-5
U16: ICE40HX4K; TQFP-144
VR1: MCP1801T-3302I/OT; SOT-23-5@1
VR2: MCP1801T-1202I/OT; SOT-23-5@1
XTAL1: 8Mhz; XTAL_4X6

Connections:
1V2: C31.2, C35.2, C36.1, C39.1, C43.2, C54.2, C55.2, U16.27 (VCC), U16.40 (VCC), U16.54 (VCCPLL0), U16.92 (VCC), U16.111 (VCC), U16.126 (VCCPLL1), VR2.5 (OUT)
3V3: C1.1, C2.1, C3.1, C4.1, C9.1, C10.1, C11.1, C12.1, C17.2, C19.+, C21.2, C22.2, C25.2, C28.1, C30.2, C32.1, C33.2, C34.2, C42.2, C44.2, C45.2, C46.2, C47.2, C48.2, C49.2, C50.2, C51.2, C52.2, C53.1, C56.2, C57.2, C58.1, C59.1, C60.2, C61.1, C62.2, C63.2, IC1.1 (VCCA), IC2.1 (VCCA), IC3.1 (VCCA), IC4.1 (VCCA), IC5.1 (VCCA), IC6.1 (VCCA), IC7.1 (VCCA), IC8.1 (VCCA), IC9.8 (V+), IC10.8 (V+), J1.1, J3.P9 (9), R1.2, R2.2, R3.2, R4.2, R13.2, R14.2, R15.2, R16.2, R25.2, R37.2, R38.2, R46.2, U1.5 (V+), U2.5 (V+), U3.5 (V+), U4.5 (V+), U5.6 (VBAT), U5.17 (VDD_5), U5.32 (VREF+), U5.33 (VDDA), U5.39 (VDD_4), U5.52 (VDD_6), U5.62 (VDD_7), U5.72 (VDD_1), U5.84 (VDD_8), U5.95 (VDD_9), U5.108 (VDD_2), U5.121 (VDD_10), U5.131 (VDD_11), U5.144 (VDD_3), U6.5 (V+), U7.5 (V+), U8.5 (V+), U9.5 (V+), U12.3 (!WP), U12.7 (!HOLD), U12.8 (VCC), U13.20 (V+), U16.6 (VCCIO_3), U16.30 (VCCIO_3), U16.46 (VCCIO_2), U16.57 (VCCIO_2), U16.72 (VCC_SPI), U16.89 (VCCIO_1), U16.100 (VCCIO_1), U16.108 (VPP_2V5), U16.123 (VCCIO_0), U16.131 (VCCIO_0), VR1.5 (OUT)
ADC1: RN3.5 (2), RN3.6 (2), U5.47 (ADC12_IN9/TIM3_CH4('00'OR'10')/TIM8_CH3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)
ADC_MUX_EN: IC11.6 (!E), U16.96 (IOR_146)
ADC_MUX_S0: IC11.11 (S0), U16.93 (GBIN3/IOR_140)
ADC_MUX_S1: IC11.10 (S1), U16.94 (GBIN2/IOR_141)
ADC_MUX_S2: IC11.9 (S2), U16.95 (IOR_144)
BPIO0: IC1.4 (B), IC11.13 (Y0), J2.1, R6.2, RN1.1, U1.4 (O), U13.18 (B0)
BPIO1: IC2.4 (B), IC11.14 (Y1), J2.2, R8.2, RN1.2 (1), U2.4 (O), U13.17 (B1)
BPIO2: IC3.4 (B), IC11.15 (Y2), J2.3, R10.2, RN1.3 (1), U3.4 (O), U13.16 (B2)
BPIO3: IC4.4 (B), IC11.12 (Y3), J2.4, R12.2, RN1.4 (1), U4.4 (O), U13.15 (B3)
BPIO4: IC5.4 (B), IC11.1 (Y4), J2.5, R18.2, RN2.5 (2), U6.4 (O), U13.14 (B4)
BPIO5: IC6.4 (B), IC11.5 (Y5), J2.6, R20.2, RN2.6 (2), U7.4 (O), U13.13 (B5)
BPIO6: IC7.4 (B), IC11.2 (Y6), J2.7, R22.2, RN2.7 (2), U8.4 (O), U13.12 (B6)
BPIO7: IC8.4 (B), IC11.4 (Y7), J2.8, R24.2, RN2.8 (2), U9.4 (O), U13.11 (B7)
BUFDIR0: IC1.5 (DIR), R5.2, U16.107 (IOR_167)
BUFDIR1: IC2.5 (DIR), R7.2, U16.113 (IOT_170)
BUFDIR2: IC3.5 (DIR), R9.2, U16.99 (IOR_152)
BUFDIR3: IC4.5 (DIR), R11.2, U16.104 (IOR_164)
BUFDIR4: IC5.5 (DIR), R17.2, U16.79 (IOR_115)
BUFDIR5: IC6.5 (DIR), R19.2, U16.75 (IOR_111)
BUFDIR6: IC7.5 (DIR), R21.2, U16.64 (CBSEL1/IOB_104)
BUFDIR7: IC8.5 (DIR), R23.2, U16.61 (IOB_96)
BUFIO0: IC1.3 (A), U16.106 (IOR_166)
BUFIO1: IC2.3 (A), U16.112 (IOT_169)
BUFIO2: IC3.3 (A), U16.98 (IOR_148)
BUFIO3: IC4.3 (A), U16.102 (IOR_161)
BUFIO4: IC5.3 (A), U16.78 (IOR_114)
BUFIO5: IC6.3 (A), U16.74 (IOR_110)
BUFIO6: IC7.3 (A), U16.63 (CBSEL0/IOB_103)
BUFIO7: IC8.3 (A), U16.60 (IOB_95)
BUFOD0: R1.1, U1.2 (I), U16.105 (IOR_165)
BUFOD1: R2.1, U2.2 (I), U16.110 (IOT_168)
BUFOD2: R3.1, U3.2 (I), U16.97 (IOR_147)
BUFOD3: R4.1, U4.2 (I), U16.101 (IOR_160)
BUFOD4: R13.1, U6.2 (I), U16.76 (IOR_112)
BUFOD5: R14.1, U7.2 (I), U16.73 (IOR_109)
BUFOD6: R15.1, U8.2 (I), U16.62 (IOB_102)
BUFOD7: R16.1, U9.2 (I), U16.56 (IOB_94)
D+: CON1.DP1, CON1.DP2, R41.1, R42.2
D-: CON1.DN1, CON1.DN2, R43.2
DISPLAY_AUX1: J3.P5 (5), U5.44 (ADC12_IN14/PC4)
DISPLAY_AUX2: J3.P4 (4), U5.45 (ADC12_IN15/PC5)
DISPLAY_CS: J3.P1 (1), U5.50 (FSMC_A6/FT/PF12)
DISPLAY_D/P: J3.P2 (2), U5.49 (FSMC_NIOS16/FT/PF11)
DISPLAY_PWM: J3.P3 (3), U5.46 (ADC12_IN8/TIM3_CH3('00'OR'10')/TIM8_CH2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)
DISPLAY_SPI_CLOCK: J3.P8 (8), U5.41 (PA5/SPI1_SCK('0')/ADC12_IN5)
DISPLAY_SPI_MISO: J3.P7 (7), U5.42 (PA6/SPI1_MISO('0')/TIM8_BKIN/ADC12_IN6/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)
DISPLAY_SPI_MOSI: J3.P6 (6), U5.43 (PA7/SPI1_MOSI('0')/TIM8_CH1N/ADC12_IN7/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)
FLASH_CS: U5.132 (PG15/FT), U12.1 (!CS)
FLASH_MISO: U5.134 (SPI3_MISO('0')/TIM3_CH1('10')/SPI1_MISO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), U12.2 (SO)
FLASH_MOSI: U5.135 (I2C1_SMBA/SPI3_MOSI('0')/TIM3_CH2('10')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), U12.5 (SI)
FLASH_SCK: U5.133 (SPI3_SCK('0')/TIM2_CH2('01')/SPI1_SCK('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), U12.6 (SCK)
FPGA_CDONE: R37.1, U5.69 (I2C2_SCL/USART3_TX('00')/TIM2_CH3('10'O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), U16.65 (CDONE)
FPGA_CRESET: R38.1, U5.70 (I2C2_SDA/USART3_RX('00')/TIM2_CH4('10'O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), U16.66 (CRESET_B)
FPGA_PROG_CLOCK: U5.74 (SPI2_SCK/USART3_CTS('00'OR'01')/TIM1_CH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), U16.70 (IOB_107/SCK)
FPGA_PROG_CS: R29.2, U5.73 (SPI2_NSS/I2C2_SMBA/USART3_CK(00)/TIM1_B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), U16.71 (IOB_108/SS)
FPGA_PROG_MISO: U5.75 (SPI2_MISO/USART3_RTS('00'OR'01')/TIM1_C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), U16.67 (IOB_105/SDO)
FPGA_PROG_MOSI: U5.76 (SPI2_MOSI/TIM1_CH3N('00')/FT/PB15), U16.68 (IOB_106/SDI)
FSMC_A0: U5.10 (FSMC_A0/FT/PF0), U16.3 (IOL_3A)
FSMC_A1: U5.11 (FSMC_A1/FT/PF1), U16.4 (IOL_3B)
FSMC_A2: U5.12 (FSMC_A2/FT/PF2), U16.7 (IOL_4A)
FSMC_A3: U5.13 (FSMC_A3/FT/PF3), U16.8 (IOL_4B)
FSMC_A4: U5.14 (FSMC_A4/FT/PF4), U16.9 (IOL_5A)
FSMC_A5: U5.15 (FSMC_A5/FT/PF5), U16.10 (IOL_5B)
FSMC_D0: U5.85 (PD14/FT/FSMC_D0/TIM4_CH3('1')), U16.24 (IOL_17B)
FSMC_D1: U5.86 (PD15/FT/FSMC_D1/TIM4_CH4('1')), U16.23 (IOL_17A)
FSMC_D2: U5.114 (PD0/FT/FSMC_D2), U16.1 (IOL_2A)
FSMC_D3: U5.115 (PD1/FT/FSMC_D3), U16.2 (IOL_2B)
FSMC_D4: U5.58 (PE7/FT/FSMC_D4/TIM1_ETR('11')), U16.15 (IOL_10A)
FSMC_D5: U5.59 (PE8/FT/FSMC_D5/TIM1_CH1N('11')), U16.16 (IOL_10B)
FSMC_D6: U5.60 (PE9/FT/FSMC_D6/TIM1_CH1('11')), U16.17 (IOL_12A)
FSMC_D7: U5.63 (PE10/FT/FSMC_D7/TIM1_CH2N('11')), U16.18 (IOL_12B)
FSMC_D8: U5.64 (PE11/FT/FSMC_D8/TIM1_CH2('11')), U16.19 (IOL_13A)
FSMC_D9: U5.65 (PE12/FT/FSMC_D9/TIM1_CH3N('11')), U16.25 (IOL_18A)
FSMC_D10: U5.66 (PE13/FT/FSMC_D10/TIM1_CH3('11')), U16.26 (IOL_18B)
FSMC_D11: U5.67 (PE14/FT/FSMC_D11/TIM1_CH4('11')), U16.28 (IOL_23A)
FSMC_D12: U5.68 (PE15/FT/FSMC_D12/TIM1_BKIN('11')), U16.29 (IOL_23B)
FSMC_D13: U5.77 (PD8/FT/FSMC_D13/USART3_TX('11')), U16.33 (IOL_25A)
FSMC_D14: U5.78 (PD9/FT/FSMC_D14/USART3_RX('11')), U16.32 (IOL_24B)
FSMC_D15: U5.79 (PD10/FT/FSMC_D15/USART3_CK('11')), U16.31 (IOL_24A)
FSMC_NE3_CE: U5.125 (PG10/FT/FSMC_NCE4_1/FSMC_NE3), U16.22 (IOL_14B)
FSMC_NOE_OE: U5.118 (PD4/FT/FSMC_NOE/USART2_RTS(1)), U16.11 (IOL_8A)
FSMC_NWE_WE: U5.119 (PD5/FT/FSMC_NWE/USART2_TX('1')), U16.12 (IOL_8B)
GND: C1.2, C2.2, C3.2, C4.2, C5.1, C6.1, C7.1, C8.1, C9.2, C10.2, C11.2, C12.2, C13.1, C14.1, C15.1, C16.1, C17.1, C18.1, C19.-, C20.1, C21.1, C22.1, C23.2, C24.2, C25.1, C26.2, C27.2, C28.2, C29.2, C30.1, C31.1, C32.2, C33.1, C34.1, C35.1, C36.2, C37.2, C38.2, C39.2, C40.2, C41.2, C42.1, C43.1, C44.1, C45.1, C46.1, C47.1, C48.1, C49.1, C50.1, C51.1, C52.1, C53.2, C54.1, C55.1, C56.1, C57.1, C58.2, C59.2, C60.1, C61.2, C62.1, C63.1, C64.-, CON1.GND@1 (GND), CON1.GND@2 (GND), CON1.P$1 (CHASSIS), CON1.P$2 (CHASSIS), CON1.P$3 (CHASSIS), CON1.P$4 (CHASSIS), CON1.P$5 (CHASSIS), CON1.P$6 (CHASSIS), CON1.P$7 (CHASSIS), CON1.P$8 (CHASSIS), IC1.2 (GND), IC2.2 (GND), IC3.2 (GND), IC4.2 (GND), IC5.2 (GND), IC6.2 (GND), IC7.2 (GND), IC8.2 (GND), IC9.4 (GND), IC10.4 (GND), IC11.7 (VEE), IC11.8 (GND), IC12.2 (GND), J1.2, J2.10, J3.P10 (10), LED1.C, LED2.C, LED3.C, LED4.C, LED5.C, LED6.C, LED7.C, LED8.C, R5.1, R6.1, R7.1, R8.1, R9.1, R10.1, R11.1, R12.1, R17.1, R18.1, R19.1, R20.1, R21.1, R22.1, R23.1, R24.1, R27.2, R29.1, R32.2, R34.1, R35.1, R40.1, R44.2, R45.2, RN3.2 (1), RN3.3 (1), U1.3 (GND), U2.3 (GND), U3.3 (GND), U4.3 (GND), U5.16 (VSS_5), U5.30 (VSSA), U5.31 (VREF-), U5.38 (VSS_4), U5.48 (BOOT1/FT/PB2), U5.51 (VSS_6), U5.61 (VSS_7), U5.71 (VSS_1), U5.83 (VSS_8), U5.94 (VSS_9), U5.107 (VSS_2), U5.120 (VSS_10), U5.130 (VSS_11), U5.138 (BOOT0), U5.143 (VSS_3), U6.3 (GND), U7.3 (GND), U8.3 (GND), U9.3 (GND), U10.7 (GND), U11.7 (GND), U12.4 (GND), U13.1 (DIR), U13.10 (GND), U13.19 (!OE), U14.2 (V-), U15.2 (V-), U16.5 (GND), U16.13 (GND), U16.14 (GND), U16.53 (GNDPLL0), U16.59 (GND), U16.69 (GND), U16.86 (GND), U16.103 (GND), U16.127 (GNDPLL1), U16.132 (GND), U16.140 (GND), VR1.2 (GND), VR2.2 (GND)
LAT0: U13.2 (A0), U16.91 (IOR_139)
LAT1: U13.3 (A1), U16.90 (IOR_138)
LAT2: U13.4 (A2), U16.88 (IOR_137)
LAT3: U13.5 (A3), U16.87 (IOR_136)
LAT4: U13.6 (A4), U16.85 (IOR_128)
LAT5: U13.7 (A5), U16.84 (IOR_120)
LAT6: U13.8 (A6), U16.83 (IOR_119)
LAT7: U13.9 (A7), U16.82 (IOR_118)
LD1: R47.2, U5.110 (PA15/FT/JTDI/SPI3_NSS('0')/TIM2_CH1_ETR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)
MCU_ADC5: R39.2, R40.2, U5.37 (PA3/USART2_RX('0')/TIM5_CH4/ADC123_IN3/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)
MCU_ADC6: RN3.7 (2), RN3.8 (2), U5.36 (PA2/USART2_TX('0')/TIM5_CH3/ADC123_IN2/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)
MCU_AUX1: U5.111 (UART4_TX/USART3_TX('01')/FT/PC10), U16.137 (IOT_215)
MCU_AUX2: U5.112 (UART4_RX/USART3_RX('01')/FT/PC11), U16.136 (IOT_214)
MCU_AUX3: U5.113 (UART5_TX/USART3_CK('01')/FT/PC12), U16.135 (IOT_213)
MCU_AUX4: U5.122 (PD6/FT/FSMC_NWAIT/USART2_RX('1')), U16.134 (IOT_212)
MCU_AUX5: U5.139 (TIM4_CH3('0')/I2C1_SCL('1')/FT/PB8), U16.130 (IOT_206)
MCU_AUX6: U5.140 (TIM4_CH4('0')/I2C1_SDA('1')/FT/PB9), U16.125 (IOT_192)
MCU_AUX7: U5.141 (PE0/FT/TIM4_ETR/FSMC_NBL0), U16.124 (IOT_191)
MCU_AUX8: U5.142 (PE1/FT/FSMC_NBL1), U16.122 (IOT_190)
MCU_AUX9: U5.53 (FSMC_A7/FT/PF13), U16.37 (IOB_56)
MCU_AUX10: U5.57 (PG1/FT/FSMC_A11), U16.38 (IOB_57)
MCU_AUX11: U5.54 (FSMC_A8/FT/PF14), U16.39 (IOB_61)
MCU_AUX12: U5.55 (FSMC_A9/FT/PF15), U16.41 (IOB_63)
MCU_INT0: U5.1 (PE2/FT/FSMC_A23), U16.129 (GBIN0/IOT_198)
MCU_INT1: U5.2 (PE3/FT/FSMC_A19), U16.49 (GBIN5/IOB_81)
MCU_MCO: U5.100 (PA8/FT/USART1_CK/TIM1_CH1('00'OR'01')/M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), U16.128 (GBIN1/IOT_197)
MCU_VPU: U5.56 (PG0/FT/FSMC_A10), U10.5 (E), U10.6 (E), U10.12 (E), U10.13 (E), U11.5 (E), U11.6 (E), U11.12 (E), U11.13 (E)
unnamed: CON1.VBUS@1 (VBUS), CON1.VBUS@2 (VBUS), L1.2 (1)
unnamed: RN1.7 (2), U10.1 (Y)
unnamed: RN1.8 (2), U10.4 (Y)
unnamed: RN1.5 (2), U10.8 (Y)
unnamed: RN1.6 (2), U10.11 (Y)
unnamed: LED3.A, LED4.A, R47.1
unnamed: LED1.A, LED2.A, R46.1
unnamed: C20.2, U5.23 (OSC_IN), XTAL1.2
unnamed: C18.2, U5.24 (OSC_OUT), XTAL1.1
unnamed: Q1.6 (C), Q2.1 (G), R35.2
unnamed: IC12.4 (ADJ), R30.2, R31.1, R32.1
unnamed: LED7.A, LED8.A, R49.1
unnamed: CON1.CC1, R44.1
unnamed: R28.1, U14.4 (-)
unnamed: LED5.A, LED6.A, R48.1
unnamed: CON1.CC2, R45.1
unnamed: R36.2, RN3.4 (1)
unnamed: R28.2, R30.1, U14.1 (OUT)
unnamed: C29.1, IC12.5 (OUT), Q1.4 (E), Q2.3 (D), R31.2
unnamed: Q1.1 (B), Q1.2 (B), Q1.3 (C), R34.2
unnamed: C24.1, R26.2, U14.3 (+)
unnamed: D1.A, R33.2, U15.3 (+)
unnamed: RN2.3 (1), U11.1 (Y)
unnamed: RN2.4 (1), U11.4 (Y)
unnamed: RN2.1, U11.8 (Y)
unnamed: RN2.2 (1), U11.11 (Y)
unnamed: IC11.3 (Z), R33.1
unnamed: R36.1, U15.1 (OUT), U15.4 (-)
PWM: U5.96 (TIM8_CH1/TIM3_CH1('11')/FT/PC6), U16.21 (GBIN6/IOL_14A)
RST: R25.1, U5.25 (NRST)
SRAM0_CLOCK: IC9.6 (SCK), U16.141 (IOT_219)
SRAM0_CS: IC9.1 (!CS), U16.144 (IOT_222)
SRAM0_SIO0: IC9.5 (SI/SIO0), U16.138 (IOT_216)
SRAM0_SIO1: IC9.2 (SO/SIO1), U16.142 (IOT_220)
SRAM0_SIO2: IC9.3 (SIO2), U16.139 (IOT_217)
SRAM0_SIO3: IC9.7 (!HOLD/SIO3), U16.143 (IOT_221)
SRAM1_CLOCK: IC10.6 (SCK), U16.118 (IOT_177)
SRAM1_CS: IC10.1 (!CS), U16.121 (IOT_181)
SRAM1_SIO0: IC10.5 (SI/SIO0), U16.116 (IOT_173)
SRAM1_SIO1: IC10.2 (SO/SIO1), U16.119 (IOT_178)
SRAM1_SIO2: IC10.3 (SIO2), U16.117 (IOT_174)
SRAM1_SIO3: IC10.7 (!HOLD/SIO3), U16.120 (IOT_179)
SWCLK: J1.4, U5.109 (PA14/FT/JTCK-SWCLK)
SWDIO: J1.3, U5.105 (PA13/FT/JTMS-SWDIO)
UART_RX: U5.102 (PA10/FT/USART1_RX('0')/TIM1_CH3('00'OR'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)
UART_TX: U5.101 (PA9/FT/USART1_TX('0')/TIM1_CH2('00'OR'0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)
USBLED: R49.2, U5.117 (PD3/FT/FSMC_CLK/USART2_CTS(1))
USB_D+: R42.1, U5.104 (PA12/FT/USART1_RTS/USBDP/TIM1_ETR('00'O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)
USB_D-: R43.1, U5.103 (PA11/FT/USART1_CTS/USBDM/TIM1_CH4('00'O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)
USB_DET: R41.2, U5.5 (PE6/FT/FSMC_A22)
VPP_FAST: U16.109 (VPP_FAST)
VREF/VOUT: C5.2, C6.2, C7.2, C8.2, C13.2, C14.2, C15.2, C16.2, IC1.6 (VCCB), IC2.6 (VCCB), IC3.6 (VCCB), IC4.6 (VCCB), IC5.6 (VCCB), IC6.6 (VCCB), IC7.6 (VCCB), IC8.6 (VCCB), J2.9, Q1.5 (E), Q2.2 (S), RN3.1, U10.2 (Z), U10.3 (Z), U10.9 (Z), U10.10 (Z), U11.2 (Z), U11.3 (Z), U11.9 (Z), U11.10 (Z)
VREGEN: IC12.3 (!SHDN), R27.1, R48.2, U5.4 (PE5/FT/FSMC_A21)
VREG_DAC: R26.1, U5.40 (PA4/SPI1_NSS('0')/USART2_CK('0')/ADC12_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)
VUSB: C23.1, C26.1, C27.1, C37.1, C38.1, C40.1, C41.1, C64.+, D1.C, IC11.16 (VCC), IC12.1 (VIN), L1.1 (2), R39.1, U10.14 (V+), U11.14 (V+), U14.5 (V+), U15.5 (V+), VR1.1 (IN), VR1.3 (EN), VR2.1 (IN), VR2.3 (EN)

Notes on the sheet:
BUS PIRATE V5
Ian Lesnet 2014
http://dangerousprototypes.com
SRAMS
IO BUFFER/GATE
BUS PIRATE I/O
PWR
MODE
VREG
PROGRAMMING HEADER
USB
INTERNAL 3.3V VREG
BUILT-IN LOGIC ANALYZER
ADC MUX + Analog buffer
USB INTERFACE
IO PULL UPS
LED INDICATORS
Open Drain output H=Z, L=L
SS pulled low for slave config mode
VPP_FAST NC
GBIN/BUF = CLOCK; 0,2,4,6=RESET; 1,3,5,7=CLOCK ENABLE MCU clock out to GBIN FSMC (OE/WE/CE) to GBIN? MCU PWM to GBIN?
DIR IO OD BP H H H H H L H L L IN H Z (input) L IN L L (open drain LOW) H X L :( (contention)
STM32 power rail
INTERNAL 1.2V VREG
SRAM_1
SRAM_2
EEPROM

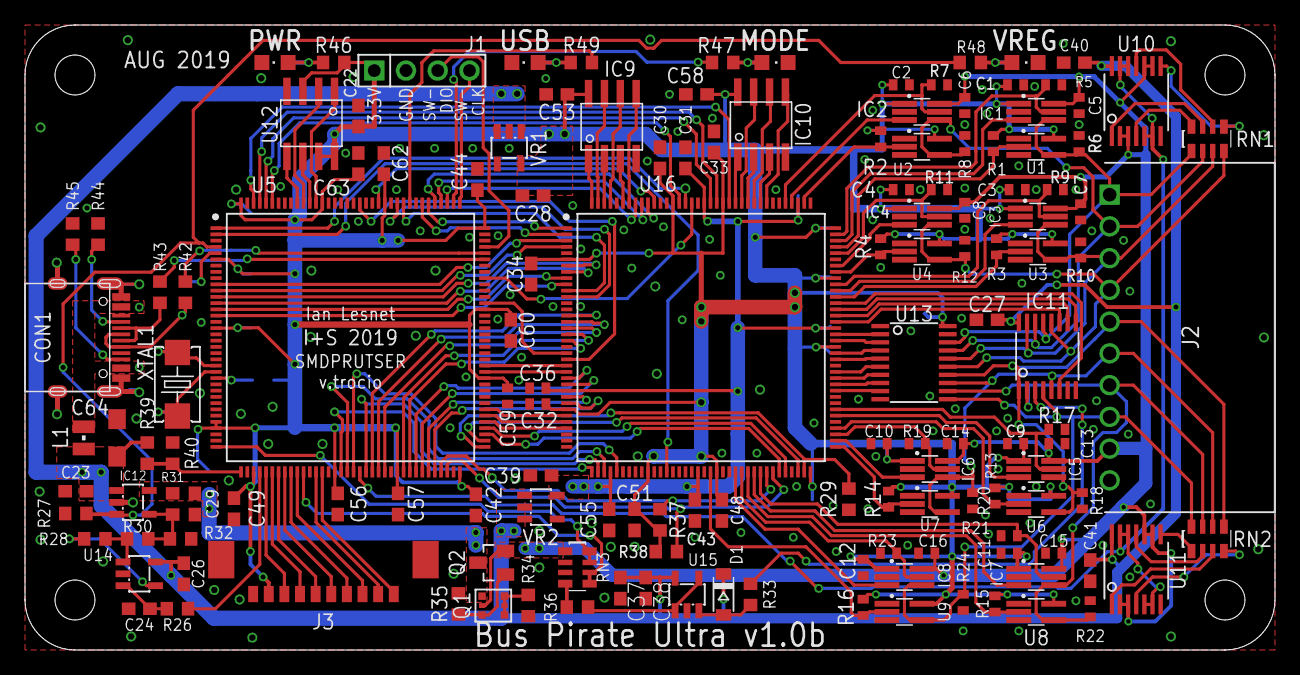
[picture p24: board BusPirate-LCD.v0a.brd from above]

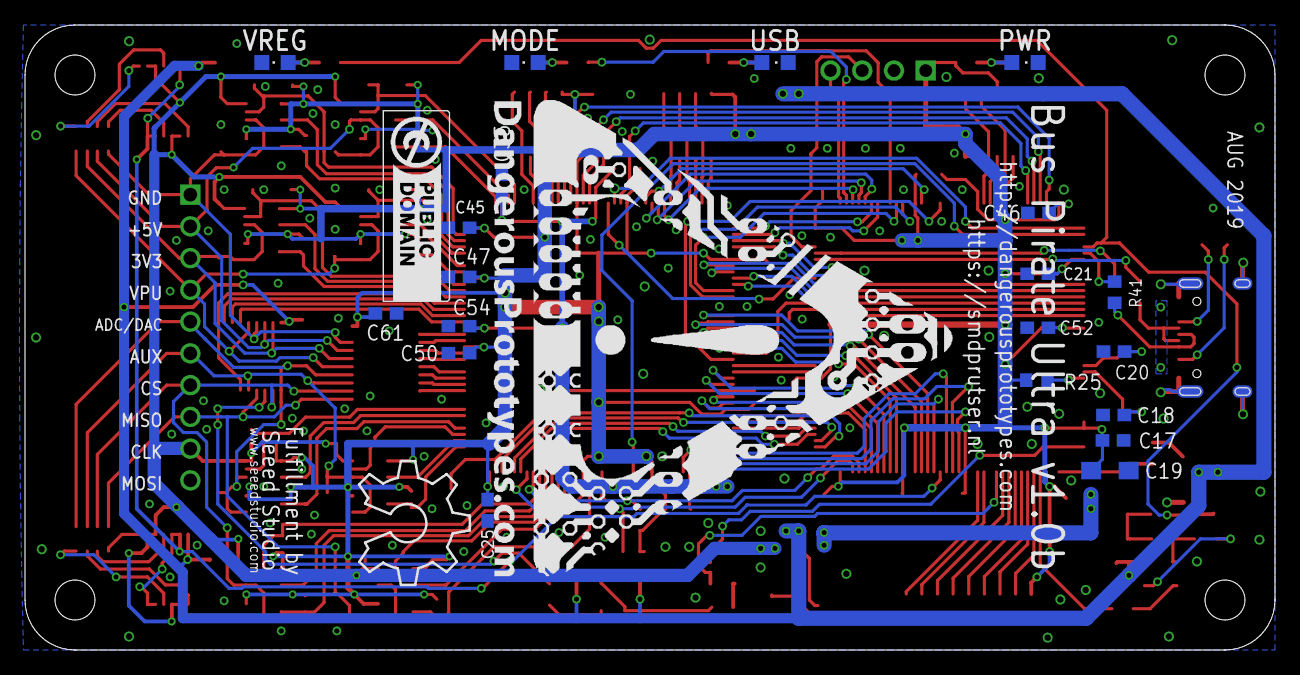
[picture p25: board BusPirate-LCD.v0a.brd from below]

Board: 2 copper layers, 100.0 x 50.0 mm, 168 parts (23 on the bottom side), 164 nets.

Other parts of the board:
U$1: DP-LOGO
U$2: OSHW_8X350_NOTEXT
U$4: DP_LOGO_ART_1.5X1.5
