DangerousPrototypes/BusPirateUltraHardware/BPU_display/BPU_display-v1d.2-28inch.brd

## EAGLE design BPU_display/BPU_display-v1d.2-28inch.brd (2019-12-14)

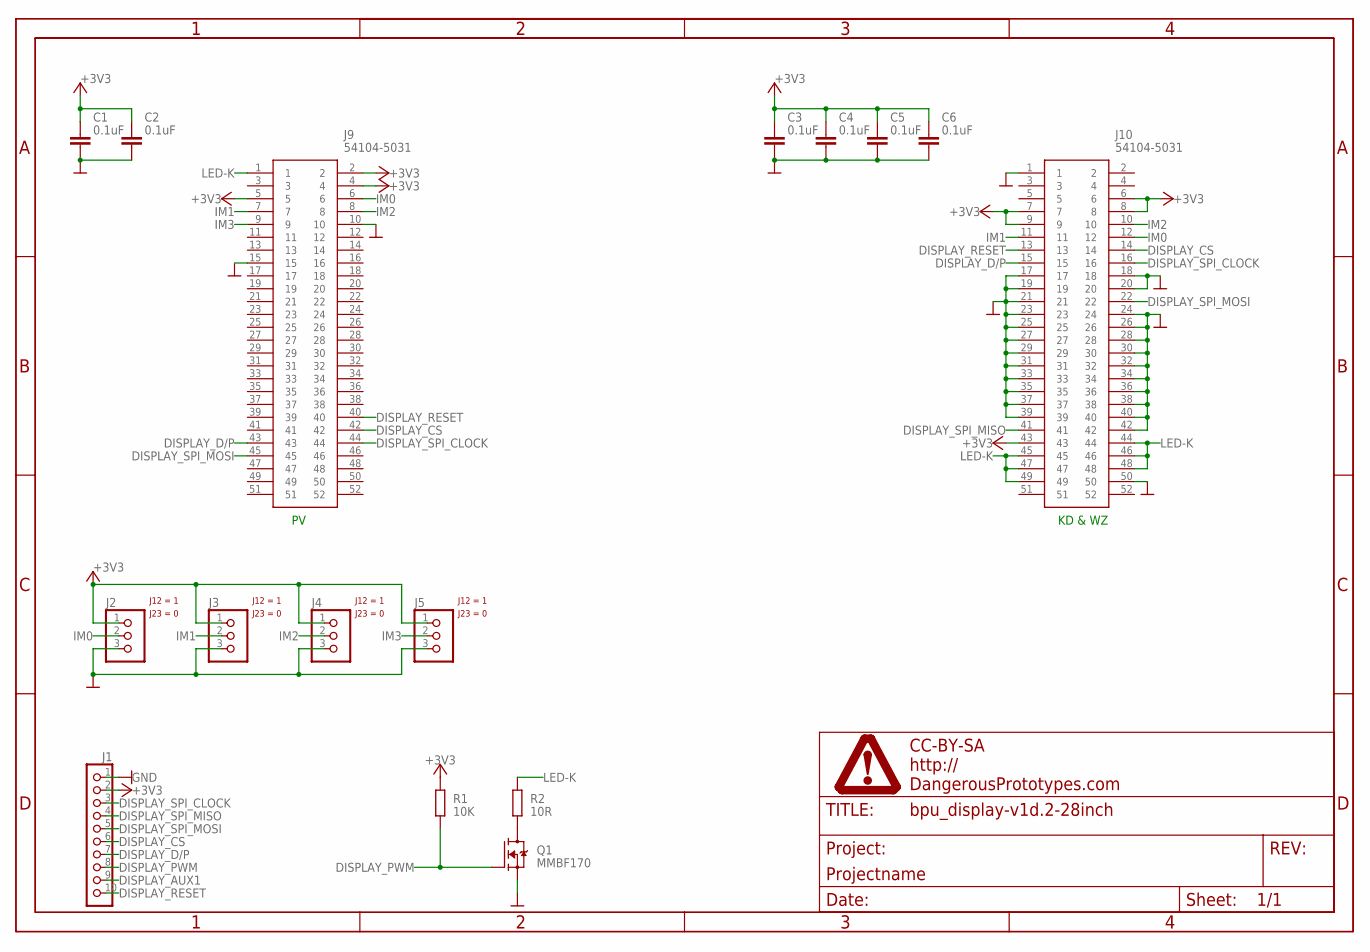
[picture p26: schematic BPU_display-v1d.2-28inch.sch]

Parts:
C1, C2, C3, C4, C5, C6: 0.1uF; C603
J1: CON-FPC_X05B20L10T; X05B20L10T
J2, J3, J4, J5: JUMPER_1X30805; JP3_0805
J9, J10: 54104-5031; 541045031
PAGE1: FRAME_DINA4_L; DP_LOGO
Q1: MMBF170; SOT-23
R1: 10K; R0603
R2: 10R; R0603

Connections:
+3V3: C1.1, C2.1, C3.1, C4.1, C5.1, C6.1, J1.2, J2.1, J3.1, J4.1, J5.1, J9.2, J9.4, J9.5, J10.6, J10.7, J10.8, J10.9, J10.43, R1.2
DISPLAY_AUX1: J1.9
DISPLAY_CS: J1.6, J9.42, J10.14
DISPLAY_D/P: J1.7, J9.43, J10.15
DISPLAY_PWM: J1.8, Q1.1 (G), R1.1
DISPLAY_RESET: J1.10, J9.40, J10.13
DISPLAY_SPI_CLOCK: J1.3, J9.44, J10.16
DISPLAY_SPI_MISO: J1.4, J10.41
DISPLAY_SPI_MOSI: J1.5, J9.45, J10.22
GND: C1.2, C2.2, C3.2, C4.2, C5.2, C6.2, J1.1, J2.3, J3.3, J4.3, J5.3, J9.10, J9.15, J10.1, J10.17, J10.18, J10.19, J10.20, J10.21, J10.23, J10.24, J10.25, J10.26, J10.27, J10.28, J10.29, J10.30, J10.31, J10.32, J10.33, J10.34, J10.35, J10.36, J10.37, J10.38, J10.39, J10.40, J10.42, J10.50, Q1.2 (S)
IM0: J2.2, J9.6, J10.12
IM1: J3.2, J9.7, J10.11
IM2: J4.2, J9.8, J10.10
IM3: J5.2, J9.9
LED-K: J9.1, J10.44, J10.45, J10.46, J10.47, J10.48, J10.49, R2.2
unnamed: Q1.3 (D), R2.1

Notes on the sheet:
KD & WZ

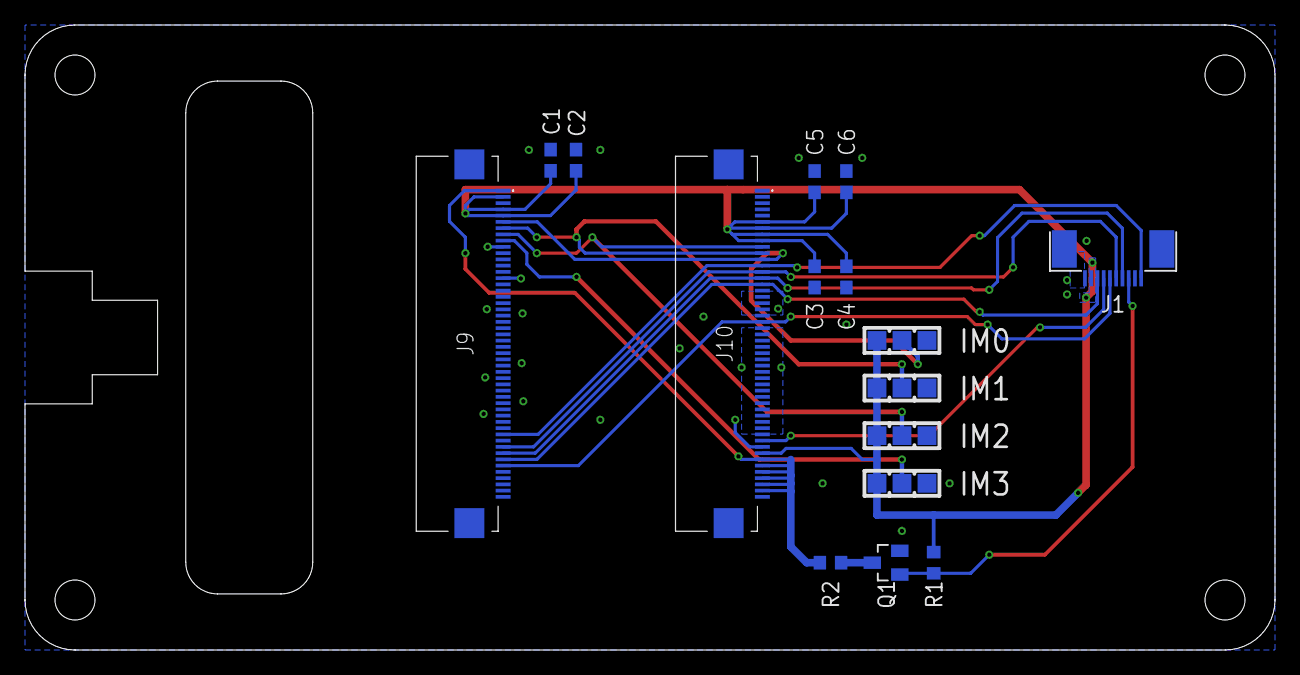
[picture p27: board BPU_display-v1d.2-28inch.brd from below]

Board: 2 copper layers, 100.0 x 50.0 mm, 17 parts (16 on the bottom side), 15 nets.
