DangerousPrototypes/BusPirateUltraHardware/BPU_display/BPU_display-v1d-20inch.brd

## EAGLE design BPU_display/BPU_display-v1d-20inch.brd (2019-12-14)

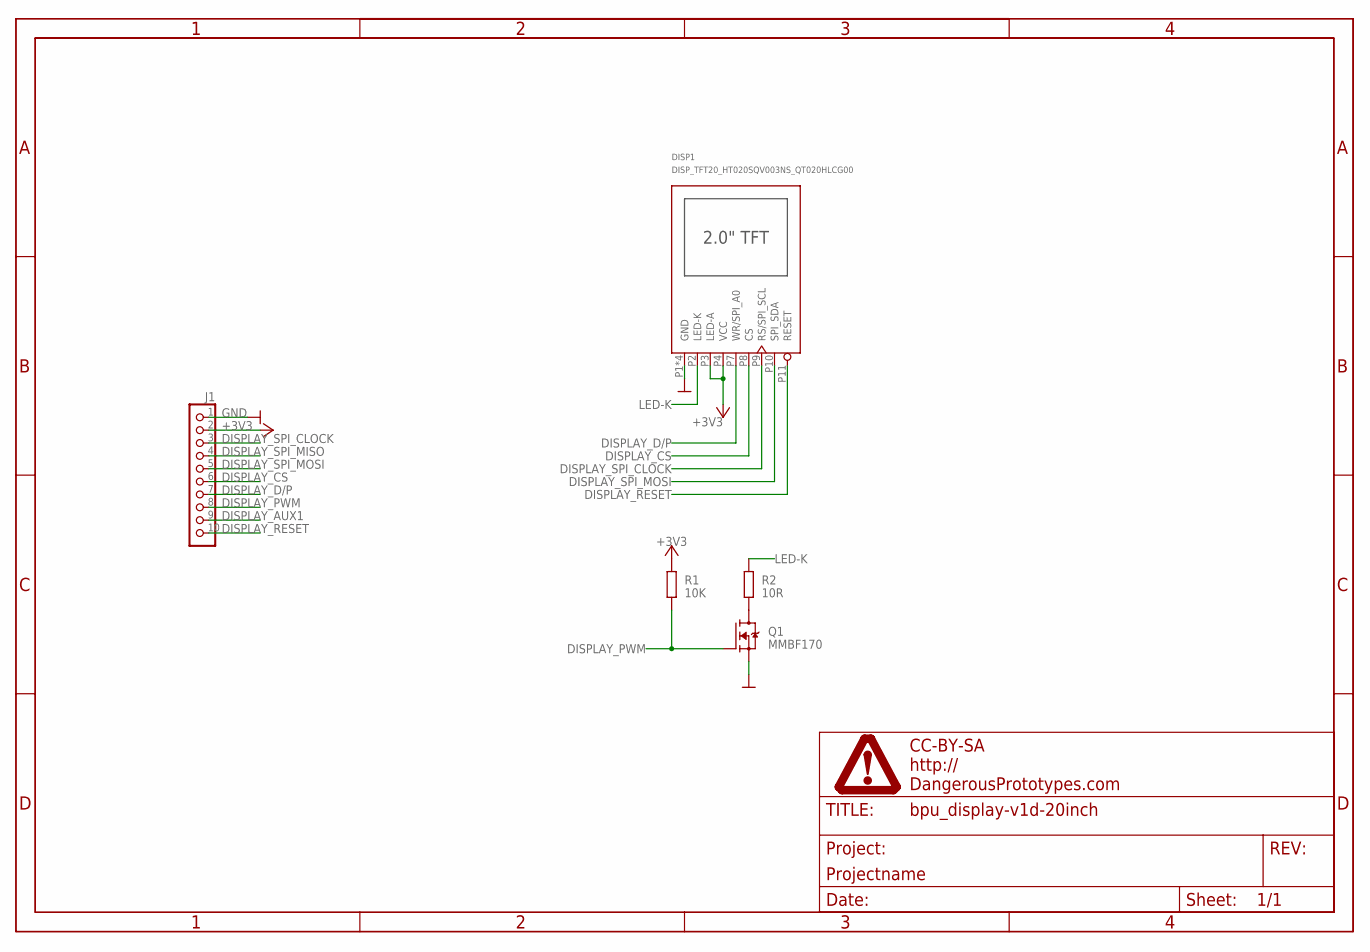
[picture p28: schematic BPU_display-v1d-20inch.sch]

Parts:
DISP1: DISP_TFT20_HT020SQV003NS_QT020HLCG00; HT020SQV003NS_QT020HLCG00
J1: CON-FPC_X05B20L10T; X05B20L10T
PAGE1: FRAME_DINA4_L; DP_LOGO
Q1: MMBF170; SOT-23
R1: 10K; R0603
R2: 10R; R0603

Connections:
+3V3: DISP1.P3 (LED-A), DISP1.P4 (VCC), J1.2, R1.2
DISPLAY_AUX1: J1.9
DISPLAY_CS: DISP1.P8 (CS), J1.6
DISPLAY_D/P: DISP1.P7 (WR/SPI_A0), J1.7
DISPLAY_PWM: J1.8, Q1.1 (G), R1.1
DISPLAY_RESET: DISP1.P11 (RESET), J1.10
DISPLAY_SPI_CLOCK: DISP1.P9 (RS/SPI_SCL), J1.3
DISPLAY_SPI_MISO: J1.4
DISPLAY_SPI_MOSI: DISP1.P10 (SPI_SDA), J1.5
GND: DISP1.P1 (GND), DISP1.P5 (GND), DISP1.P6 (GND), DISP1.P12 (GND), J1.1, Q1.2 (S)
LED-K: DISP1.P2 (LED-K), R2.2
unnamed: Q1.3 (D), R2.1

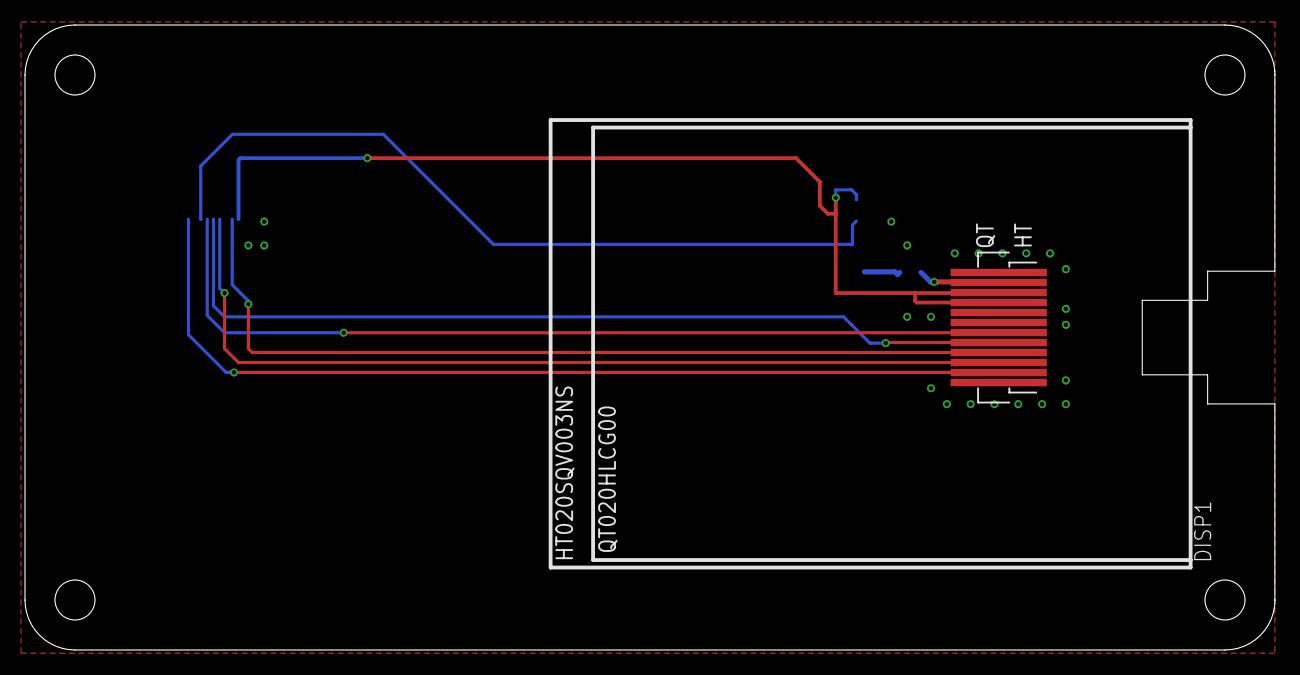
[picture p29: board BPU_display-v1d-20inch.brd from above]

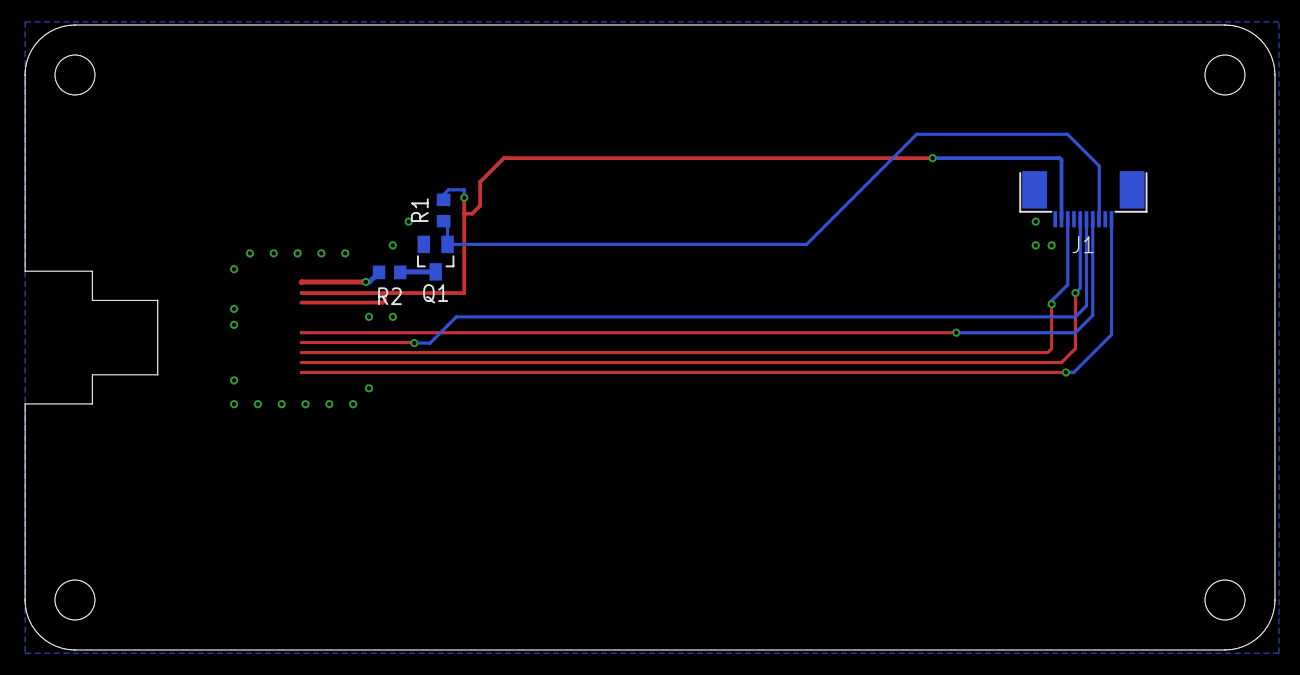
[picture p30: board BPU_display-v1d-20inch.brd from below]

Board: 2 copper layers, 100.0 x 50.0 mm, 6 parts (4 on the bottom side), 10 nets.
