DangerousPrototypes/BusPirateUltraHardware/Plugs/25LC020A.brd

## EAGLE design Plugs/25LC020A.brd (2019-12-14)

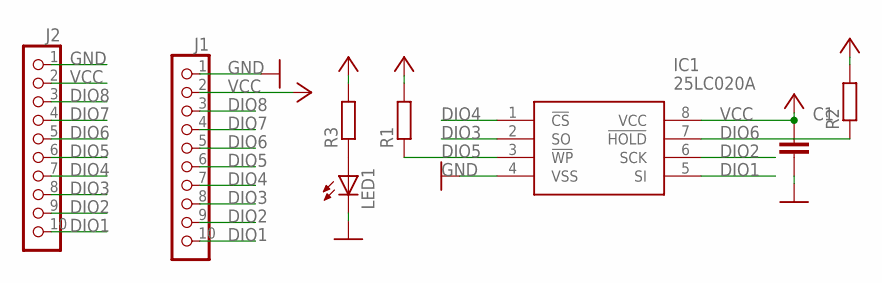
[picture p31: schematic 25LC020A.sch]

Parts:
C1: CAPACITOR_NPOL-0603; C603
IC1: 25LC020A; SOIC127P600X175-8N
J1: CON_HEADER_1X10-RIGHT_ANGLED_PTH; M1X10_FEMALE_RIGHT_ANGLED_PTH
J2: CON_HEADER_1X10-PTH; M1X10
LED1: LED-0805; LED-805
R1, R2, R3: RESISTOR-0603; R603

Connections:
DIO1: IC1.5 (SI), J1.10, J2.10
DIO2: IC1.6 (SCK), J1.9, J2.9
DIO3: IC1.2 (SO), J1.8, J2.8
DIO4: IC1.1 (!CS), J1.7, J2.7
DIO5: IC1.3 (!WP), J1.6, J2.6, R1.1
DIO6: IC1.7 (!HOLD), J1.5, J2.5, R2.1
DIO7: J1.4, J2.4
DIO8: J1.3, J2.3
GND: C1.2, IC1.4 (VSS), J1.1, J2.1, LED1.C
unnamed: LED1.A, R3.1
VCC: C1.1, IC1.8 (VCC), J1.2, J2.2, R1.2, R2.2, R3.2

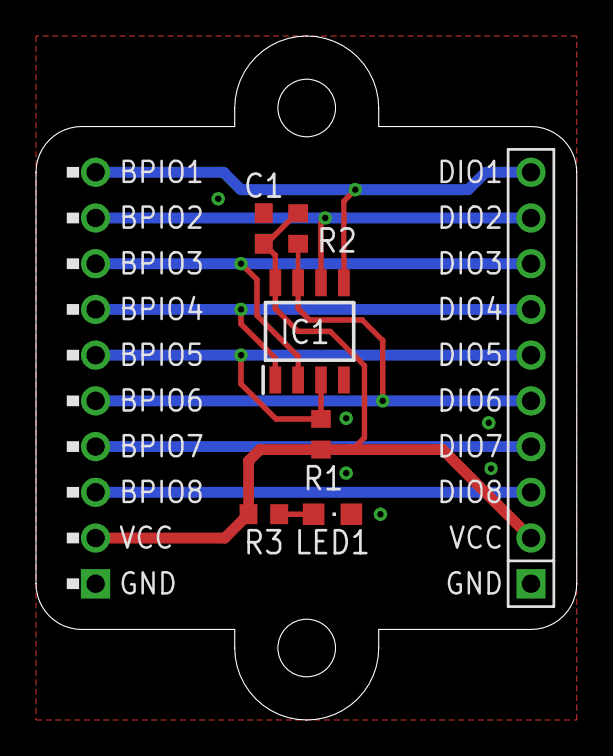
[picture p32: board 25LC020A.brd from above]

Board: 2 copper layers, 30.0 x 38.0 mm, 8 parts (0 on the bottom side), 11 nets.
