DangerousPrototypes/BusPirateUltraHardware/TestBoardv1/BusPirate-ultra-testboard.v1.0.brd

## EAGLE design TestBoardv1/BusPirate-ultra-testboard.v1.0.brd (2019-09-10)

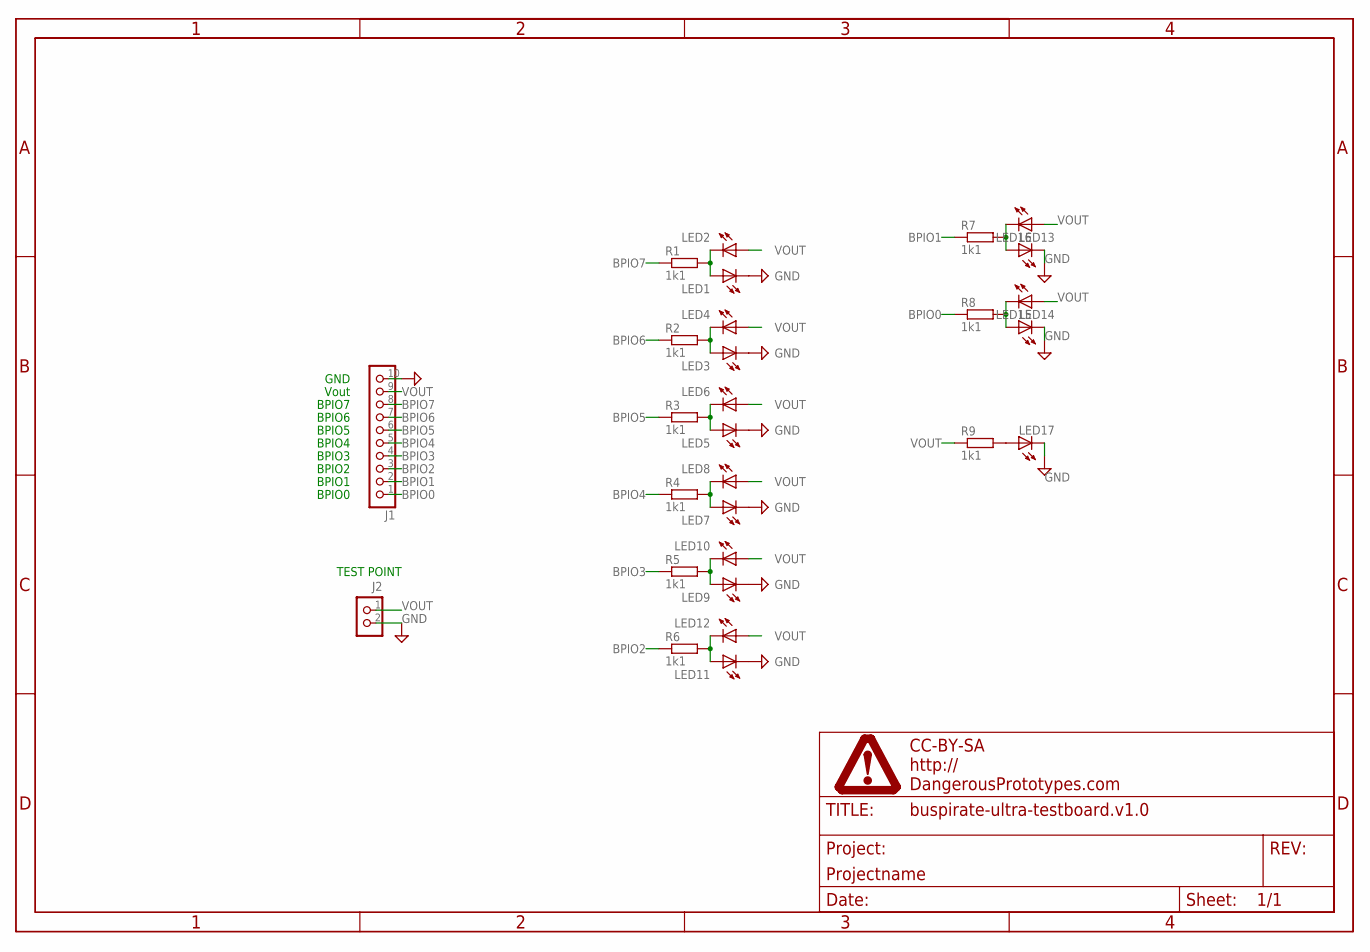
[picture p37: schematic BusPirate-ultra-testboard.v1.0.sch]

Parts:
J1: CON_HEADER_1X10-RIGHT_ANGLED_PTH; M1X10_FEMALE_RIGHT_ANGLED_PTH
J2: CON_HEADER_1X02-PTH; M1X2
LED1, LED2, LED3, LED4, LED5, LED6, LED7, LED8, LED9, LED10, LED11, LED12, LED13, LED14, LED15, LED16, LED17: LED-0805; LED-805
PAGE1: FRAME_DINA4_L; DP_LOGO
R1, R2, R3, R4, R5, R6, R7, R8, R9: 1k1; R603

Connections:
BPIO0: J1.1, R8.1
BPIO1: J1.2, R7.1
BPIO2: J1.3, R6.1
BPIO3: J1.4, R5.1
BPIO4: J1.5, R4.1
BPIO5: J1.6, R3.1
BPIO6: J1.7, R2.1
BPIO7: J1.8, R1.1
GND: J1.10, J2.2, LED1.C, LED3.C, LED5.C, LED7.C, LED9.C, LED11.C, LED13.C, LED14.C, LED17.C
unnamed: LED1.A, LED2.C, R1.2
unnamed: LED3.A, LED4.C, R2.2
unnamed: LED5.A, LED6.C, R3.2
unnamed: LED7.A, LED8.C, R4.2
unnamed: LED9.A, LED10.C, R5.2
unnamed: LED11.A, LED12.C, R6.2
unnamed: LED14.A, LED15.C, R8.2
unnamed: LED13.A, LED16.C, R7.2
unnamed: LED17.A, R9.2
VOUT: J1.9, J2.1, LED2.A, LED4.A, LED6.A, LED8.A, LED10.A, LED12.A, LED15.A, LED16.A, R9.1

Notes on the sheet:
BPIO0
Vout
BPIO7
BPIO6
BPIO5
BPIO4
BPIO3
BPIO2
BPIO1
GND
TEST POINT

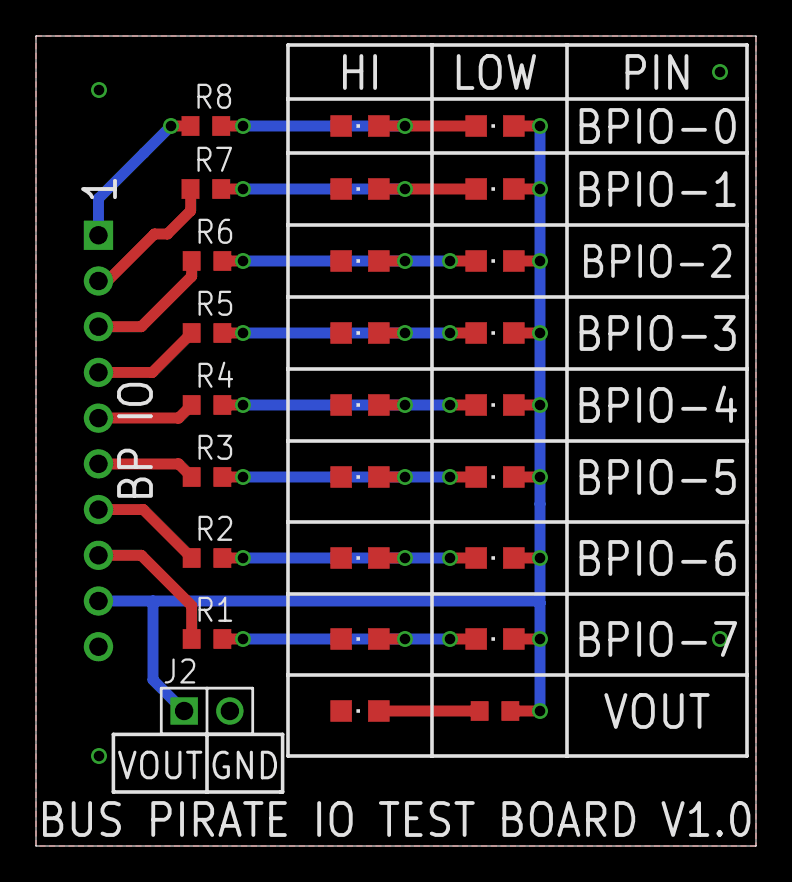
[picture p38: board BusPirate-ultra-testboard.v1.0.brd from above]

Board: 2 copper layers, 40.0 x 45.0 mm, 29 parts (1 on the bottom side), 19 nets.
