DangerousPrototypes/BusPirateUltraHardware/BPU_display/BPU_display.brd

## EAGLE design BPU_display/BPU_display.brd (2019-09-06)

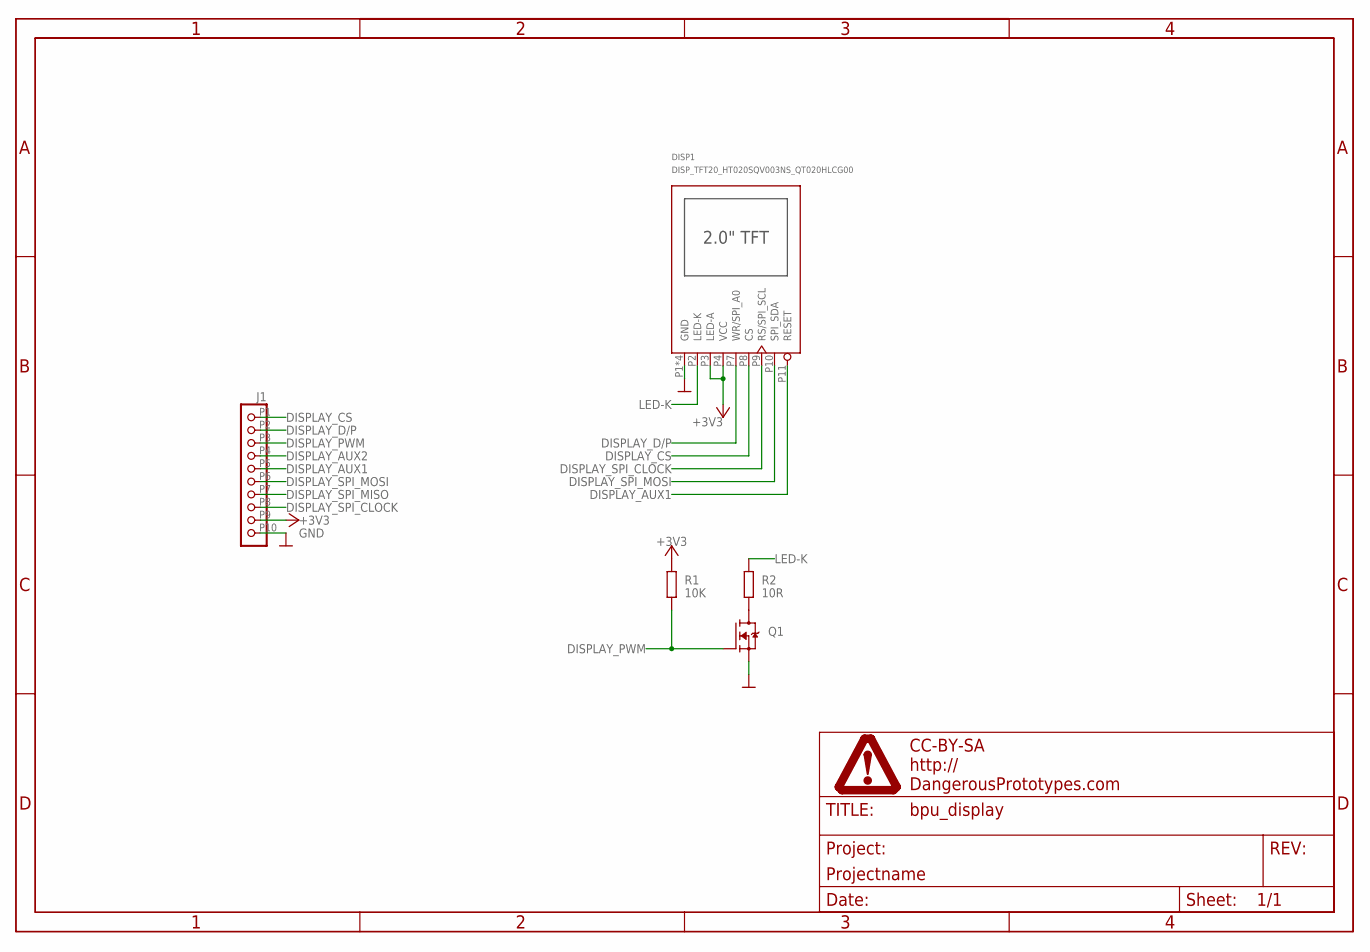
[picture p39: schematic BPU_display.sch]

Parts:
DISP1: DISP_TFT20_HT020SQV003NS_QT020HLCG00; HT020SQV003NS_QT020HLCG00
J1: CON_MOLEX_MALE_SMT_RIGHT_ANGLE_1.25; MOLEX_532611071
PAGE1: FRAME_DINA4_L; DP_LOGO
Q1: TRANSISTOR_FET_BS170-SOT-23; SOT-23
R1: 10K; R0603
R2: 10R; R0603

Connections:
+3V3: DISP1.P3 (LED-A), DISP1.P4 (VCC), J1.P9 (9), R1.2
DISPLAY_AUX1: DISP1.P11 (RESET), J1.P5 (5)
DISPLAY_AUX2: J1.P4 (4)
DISPLAY_CS: DISP1.P8 (CS), J1.P1 (1)
DISPLAY_D/P: DISP1.P7 (WR/SPI_A0), J1.P2 (2)
DISPLAY_PWM: J1.P3 (3), Q1.1 (G), R1.1
DISPLAY_SPI_CLOCK: DISP1.P9 (RS/SPI_SCL), J1.P8 (8)
DISPLAY_SPI_MISO: J1.P7 (7)
DISPLAY_SPI_MOSI: DISP1.P10 (SPI_SDA), J1.P6 (6)
GND: DISP1.P1 (GND), DISP1.P5 (GND), DISP1.P6 (GND), DISP1.P12 (GND), J1.P10 (10), Q1.2 (S)
LED-K: DISP1.P2 (LED-K), R2.2
unnamed: Q1.3 (D), R2.1

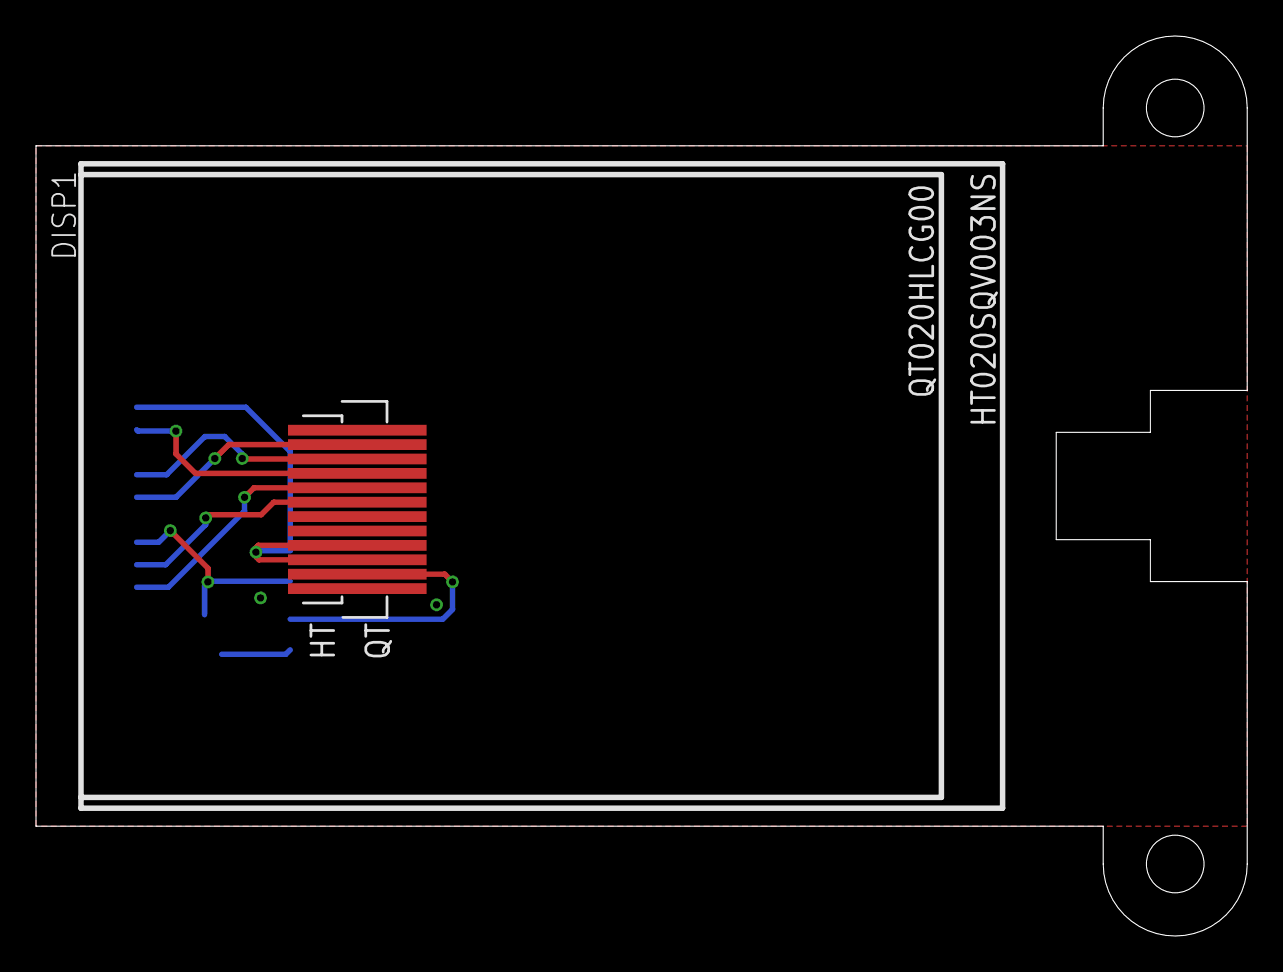
[picture p40: board BPU_display.brd from above]

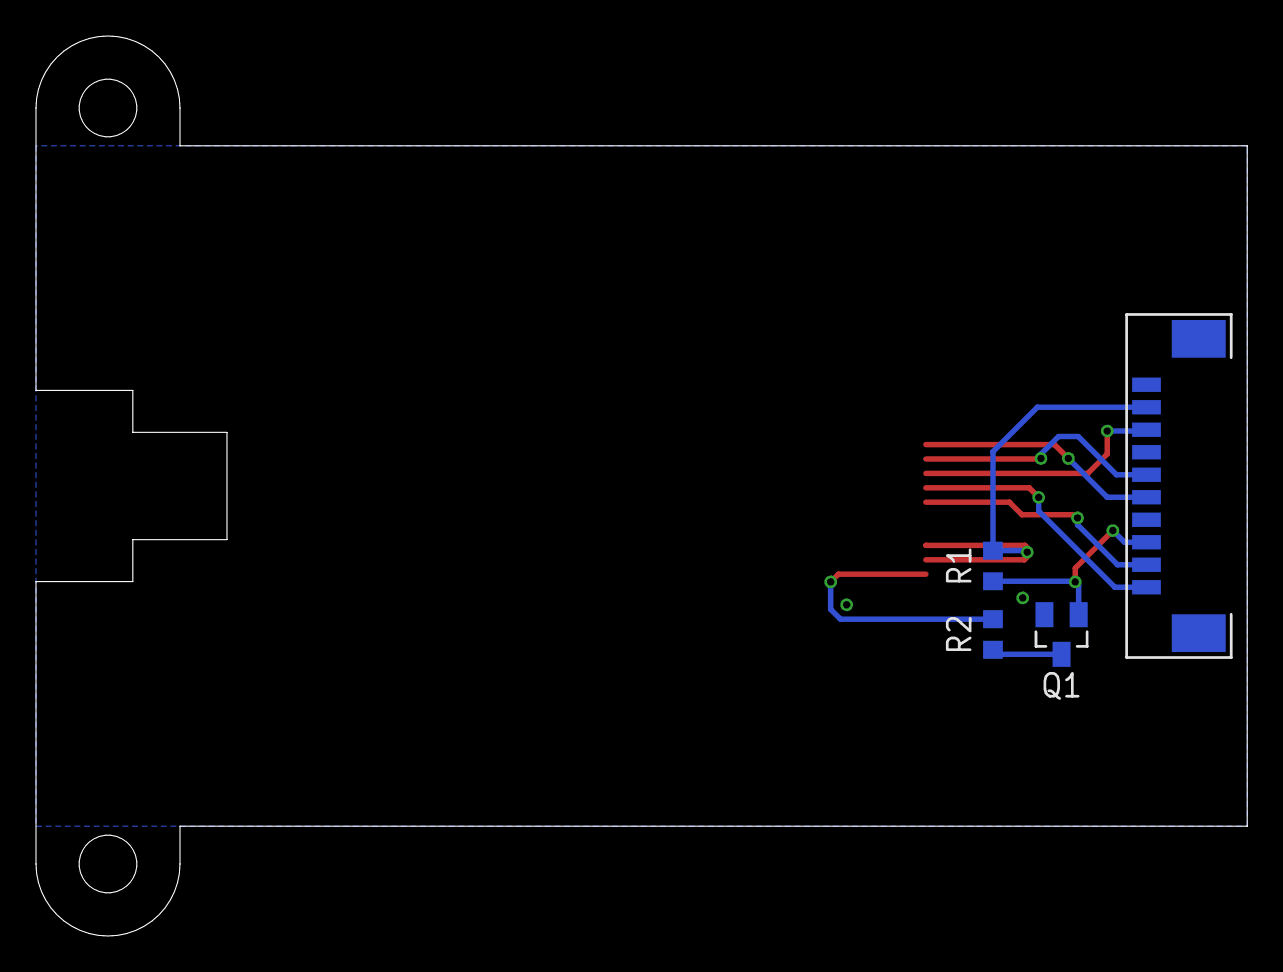
[picture p41: board BPU_display.brd from below]

Board: 2 copper layers, 67.3 x 50.0 mm, 6 parts (4 on the bottom side), 10 nets.
