DangerousPrototypes/BusPirateUltraHardware/(commit log)

2019-08-26 initial check in from old repo https://github.com/DangerousPrototypes/Bus_Pirate_Ultra
    [BusPirate-ultra-testboard.v1.0.brd, BusPirate-ultra-testboard.v1.0.sch, BusPirate-ultra.v1.0a.brd, BusPirate-ultra.v1.0a.sch, BusPirate-ultra.v1.0b.brd, BusPirate-ultra.v1.0b.sch]
2019-08-26 spreadsheets for calculating margining on the Vreg
    [vreg-dac.ods, vreg-pot.ods]
2019-08-28 continue routing
    [BusPirate-ultra.v1.0b.brd, BusPirate-ultra.v1.0b.sch]
2019-08-28 routed power traces
    [BusPirate-ultra.v1.0b.brd]
2019-08-29 board routing done, add usbc bottom PTH chassis mount library
    [BusPirate-ultra.v1.0b.brd, BusPirate-ultra.v1.0b.sch]
2019-08-30 creted gerber for v1b
2019-09-06 added BP 'sail' daughter board
    [BPU_display.brd, BPU_display.sch]
2019-09-06 make IO connector protrusion clearance to 1.5mm
    [BPU_display.brd]
2019-09-06 add DWG reference
    [board_outline.dwg]
2019-09-10 added vout and GND test point. add LED status to vout
    [BusPirate-ultra-testboard.v1.0.brd, BusPirate-ultra-testboard.v1.0.sch]
2019-09-11 fix testboard IO header to match v1b, created gerbers
    [BusPirate-ultra-testboard.v1.0.brd, BusPirate-ultra-testboard.v1.0.sch]
2019-09-24 new BPUltra.v.1.0C revision broke RN3 to individual 10K R603 resistors Added 1uF 0603 cap to U14 connect OE and DIR of latch (245) to FPGA Change values of the following parts: R27 to 100K R32 to 10K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
    [BusPirate-ultra.v1.0c.brd, BusPirate-ultra.v1.0c.sch]
2019-10-03 fix bom parts naming change back to original SC-70-5 and SC-70-6 footprints for 74LVC1G07DBV and SN74LVC1T45DBV added decoupling caps for open drain buffers(on going)
    [BusPirate-ultra.v1.0b.brd, BusPirate-ultra.v1.0b.sch]
2019-10-04 Revert previous commit to v1b, wrong version commited. changes should be on v1c not v1b.
    This reverts commit d10a26b079303959180bb4ab2616075854f9b9d1.
    [BusPirate-ultra.v1.0b.brd, BusPirate-ultra.v1.0b.sch]
2019-10-05 new BPUltra.v.1.0C revision removed some text labels renamed BPIO pin labels fix bom parts naming change back to original SC-70-5 and SC-70-6 footprints for 74LVC1G07DBV and SN74LVC1T45DBV added deco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
    [BusPirate-ultra.v1.0c.brd, BusPirate-ultra.v1.0c.sch]
2019-10-05 re-number parts logically changed C302 to 1uF add 4.7uF input cap on VR1 add 4.7uF input cap on VR2 add RC filter 25R and 1.5nF on ADC MUX buffer
    [BusPirate-ultra.v1.0c.brd, BusPirate-ultra.v1.0c.sch]
2019-10-10 added ADC ADS7041 and wired to FPGA pin 45, 47 and 48 changed 3.3V regulator to bigger MCP1700 changed mux to 16-bit version 74HCT4067, added one new address line S3 to FPGA (not connected yet) conne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
    [BusPirate-ultra.v1.0c.brd, BusPirate-ultra.v1.0c.sch]
2019-10-10 change supply of ADC chip to 3.3V
    [BusPirate-ultra.v1.0c.brd, BusPirate-ultra.v1.0c.sch]
2019-10-15 updates on v1c schematic moved MCU_VPU to PA9, free up A10 moved DISPLAY_CS to PF11 (former DISPLAY_D/P) and DISPLAY_D/P to PB1, free up A6 moved FPGA MCU_INT1 from GBIN5 to FPGA pin 115 wired PG8 to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
    [BusPirate-ultra.v1.0c.brd, BusPirate-ultra.v1.0c.sch]
2019-10-15 renamed DISPLAY_AUX2 to DISPLAY_AUX1 connected to PB1 renamed DISPLAY_AUX1 to DISPLAY_RESET and connected to PB2/BOOT1, wired a pull down resistor too rewired DISPLAY_CS from PF11 to PC4 rewired DISP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
    [BusPirate-ultra.v1.0c.brd, BusPirate-ultra.v1.0c.sch]
2019-10-15 rewiring of v1c schematic continues
    renamed MCU_AUX7 to MCU_INT0
    renamed MCU_AUX8 to MCU_INT1
    renamed MCU_INT0 to MCU_PWM0
    renamed PWM to MCU_PWM1
    moved LAT_OE to FPGA pin 96
    moved LAT_DIR to FPGA pin 95
    moved LAT_0 to FPGA pin 94
    moved LAT_1 to FPGA pin 93
    moved LAT_2 to FPGA pin 91
    moved LAT_3 to FPGA pin 90
    moved LAT_4 to FPGA pin 88
    moved LAT_5 to FPGA pin 87
    moved LAT_6 to FPGA pin 85
    moved LAT_7 to FPGA pin 84
    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
    [BusPirate-ultra.v1.0c.brd, BusPirate-ultra.v1.0c.sch]
2019-10-16 continued on v1c schematic changes renamed MCU_AUX4 to MCU_INT3 and move it from MCU PD6 to PD2 renamed MCU_INT1I to MCU_AUX0 fix display connections
    [BusPirate-ultra.v1.0c.brd, BusPirate-ultra.v1.0c.sch]
2019-10-16 continue on v1c schematic revisions -removed net DISPLAY_CSI on MCU pin 49 -renamed MCU_AUX5 to MCU_AUX4 and MCU_AUX6 to MCU_AUX5 -renamed MCU_ADC5 to MCU_ADC2 -renamed MCU_ADC6 to MCU_ADC3 -wired MC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
    [BusPirate-ultra.v1.0c.brd, BusPirate-ultra.v1.0c.sch]
2019-10-20 finishing up routing on v1c board
    [BusPirate-ultra.v1.0c.brd, BusPirate-ultra.v1.0c.sch]
2019-10-22 change display connector to FPC connector, done routing
    [BusPirate-ultra.v1.0c.brd, BusPirate-ultra.v1.0c.sch]
2019-11-02 update reference dwg
    [board_outline.dwg]
2019-12-14 display board, fonts, 25lc eeprom breakout test board
    [25LC020A.brd, 25LC020A.sch, BPU_display-v1d-20inch.brd, BPU_display-v1d-20inch.sch, BPU_display-v1d.2-28inch.brd, BPU_display-v1d.2-28inch.sch, Isense.ods]
2019-12-14 display board reorganization.
    [BPU_display-v1d-28inch.brd, BPU_display-v1d-28inch.sch, BusPirate-LCD.v0a.brd, BusPirate-LCD.v0a.sch, Isense.ods]
2020-04-21 preliminary commit of Bus Pirate Ultra v2, additional designs attribute to ULX3s https://github.com/emard/ulx3s and Butterstick https://github.com/gregdavill/ButterStick
    [BPUv2a.kicad_pcb, BPUv2a.sch, bpu-dac_adc_mux.sch, bpu-fpga.sch, bpu-iobufffer.sch, bpu-micro.sch, flash.sch, gpdi.sch]
2020-06-01 added 3d model of bus pirate ultra v1 case in freecad
    [All Bus Pirate Ultra v1.0 assembly.FCStd, Bus Pirate Ultra v1.0 bottom plate.FCStd, Bus Pirate Ultra v1.0 case.FCStd, PCB Bus Pirate Ultra v1.0 - assembly.FCStd, PCB Bus Pirate Ultra v1.0 display.FCStd, PCB Bus Pirate Ultra v1.0.FCStd, Part molex 7055 30044.FCStd, Part type-c-31-m-12-1.FCStd]
2021-04-13 Added boxy corner version of the case on v1.1
    [Bus Pirate Ultra v1.1 bottom plate.FCStd, Bus Pirate Ultra v1.1 case.FCStd]
2021-04-14 added v1.2 case, revert usb port back to rounded corner hole
    [Bus Pirate Ultra v1.2 case.FCStd]
