DangerousPrototypes/BusPirateUltraHardware/(notices)

Notices in the files:
BPU_display/BPU_display-v1d-28inch.brd:
LICENSE: CC-BY-SA
